hvitis/PingPongLauncher/docs/assets/plates/plate-01.png

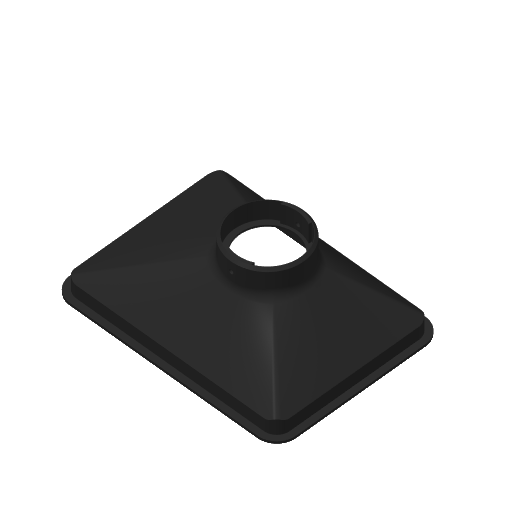
docs/assets/plates/plate-01.png
