hvitis/PingPongLauncher/docs/assets/plates/plate-02.png

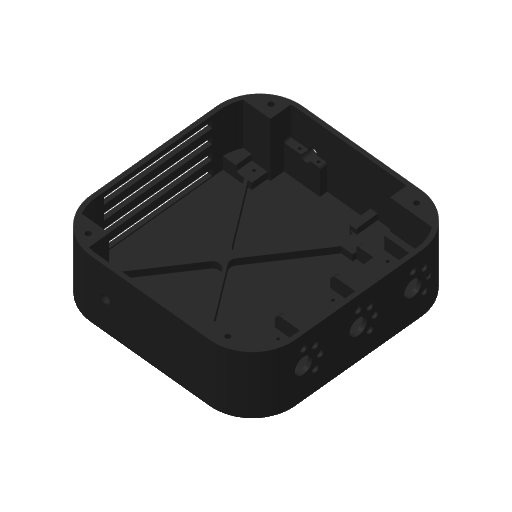
docs/assets/plates/plate-02.png
