hvitis/PingPongLauncher/docs/assets/plates/plate-03.png

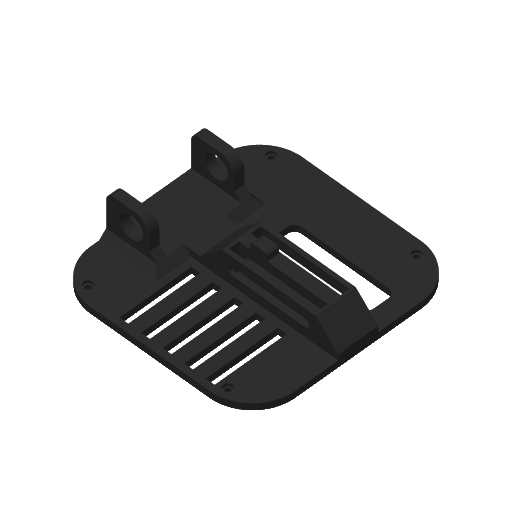
docs/assets/plates/plate-03.png
