hvitis/PingPongLauncher/docs/assets/plates/plate-04.png

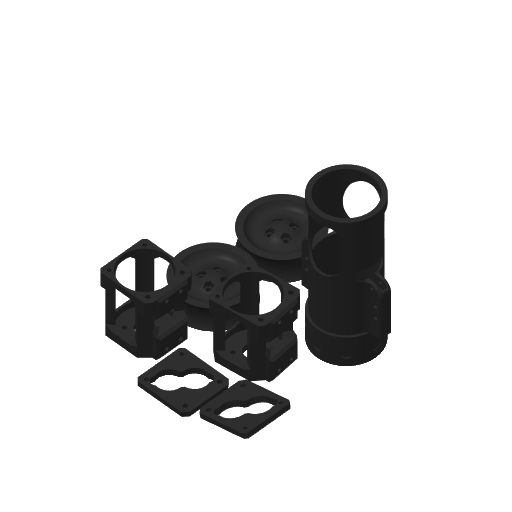
docs/assets/plates/plate-04.png
