hvitis/PingPongLauncher/docs/assets/plates/plate-05.png

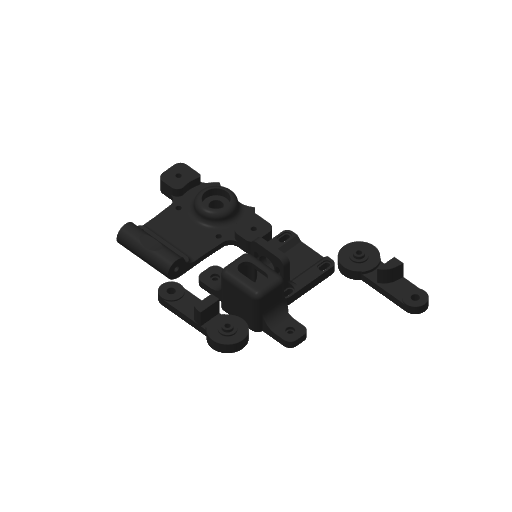
docs/assets/plates/plate-05.png
