hvitis/PingPongLauncher/docs/assets/plates/plate-06.png

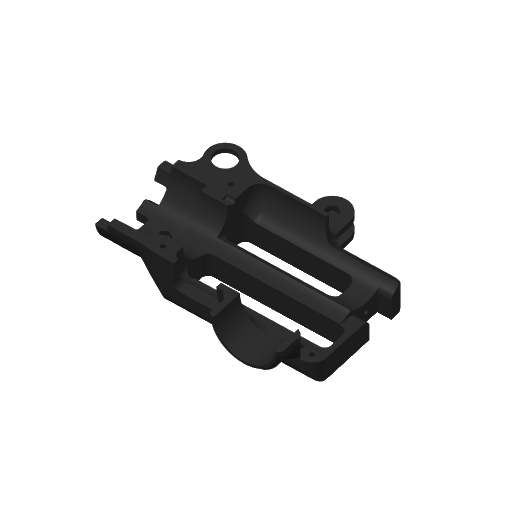
docs/assets/plates/plate-06.png
