hvitis/PingPongLauncher/docs/assets/plates/plate-08.png

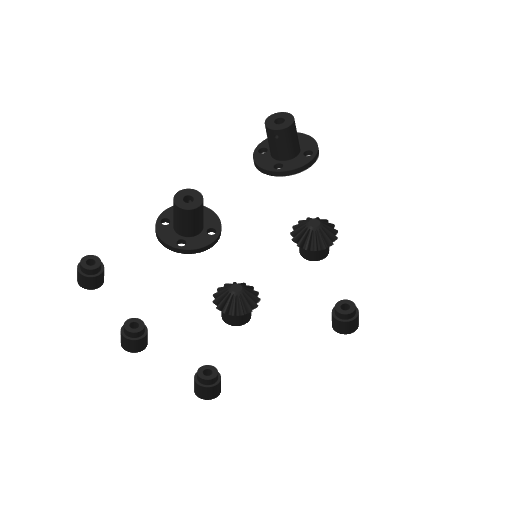
docs/assets/plates/plate-08.png
