hvitis/PingPongLauncher/docs/assets/plates/plate-09.png

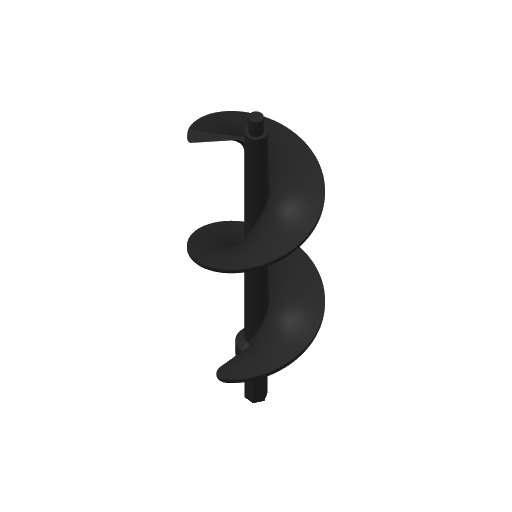
docs/assets/plates/plate-09.png
