hvitis/PingPongLauncher/docs/assets/plates/plate-10.png

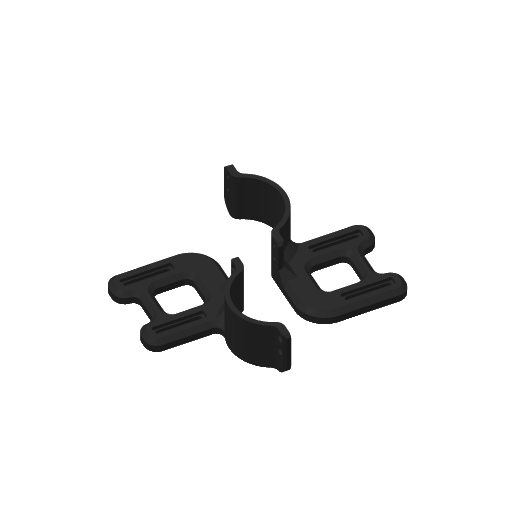
docs/assets/plates/plate-10.png
