hvitis/PingPongLauncher/docs/component-image-sources.md

# Component image sources and reference records

This document records the source photographs, vector illustrations, visual evidence, rights statements, and limitation notes for each component in the bill of materials.

## Purpose and scope

Photographs and SVG illustrations in this build guide serve visual identification only:

- **Listing photo (`listing`)**: Photographed from candidate supplier listings (Botland) to help identify commercial items. Printed pocket fits, batch tolerances, and electrical ratings must still be verified against the physical parts.
- **Reference (`reference`)**: Representative product or hardware family photographs from manufacturer or distributor listings. Used to illustrate general physical appearance; dimensions, grades, lengths, or electrical characteristics may differ from the source specification.
- **Material (`material`)**: Depicts raw material stock (such as a 3D-printing filament spool) rather than a finished or custom-fabricated component (such as a safety guard).

WARNING: These illustrations and photographs depict physical appearance only. They are not dimensioned engineering drawings, CAD models, or certified proof of fit or compatibility. Copyright in product photographs remains with the respective source photographers and retailers.

## Component visual references

| ID | Part | Scope | Photo credit / source | Visible features | Limitations and notes |
|---|---|---|---|---|---|
| H01 | M3 heat-set inserts | Reference | [Prusa / CNC Kitchen product photography](https://www.prusa3d.com/product/heat-set-inserts-m3-standard-100-pcs/) | Brass cylindrical body; Knurled outer bands; Dark threaded center opening | The photo shows a CNC Kitchen M3 insert variant, not a verified M3 × 5 × 5 mm match. |
| H02 | Socket head screws | Reference | [Westfield Fasteners product photography](https://www.westfieldfasteners.co.uk/Bolts-Screws-Metric/Socket-Head-Cap-Screw-M3x65-A4-Stainless.html) | Cylindrical socket head; Recessed hex drive; Silver threaded shank | Socket-screw appearance only. The reference is an A4 fastener family image, not proof of source 304 grade or length. |
| H03 | Socket head screws | Reference | [Westfield Fasteners product photography](https://www.westfieldfasteners.co.uk/Bolts-Screws-Metric/Socket-Head-Cap-Screw-M3x65-A4-Stainless.html) | Cylindrical socket head; Short threaded shank; Metallic finish | The same family photo is used for different screw rows. The diagram is not a scale or length guide. |
| H04 | Socket head screws | Reference | [Westfield Fasteners product photography](https://www.westfieldfasteners.co.uk/Bolts-Screws-Metric/Socket-Head-Cap-Screw-M3x65-A4-Stainless.html) | Cylindrical socket head; Recessed drive; Threaded shank | Family photo only; M3 × 25 mm length and material are specified by the BOM, not established by this illustration. |
| H05 | Socket head screws | Reference | [Westfield Fasteners product photography](https://www.westfieldfasteners.co.uk/Bolts-Screws-Metric/Socket-Head-Cap-Screw-M3x65-A4-Stainless.html) | Long smooth shank on one photographed screw; Threaded end; Cylindrical socket head | The drawing distinguishes a long screw visually but does not define M3 × 65 mm geometry, pitch, or thread length. |
| H06 | Geared feed motor | Reference | [Pololu product photography](https://www.pololu.com/product/4756) | Round metal gearbox face; Output shaft; Motor can and encoder wiring | The photo is a Pololu 4756 with a different body, shaft, and encoder package. It is not a verified feeder replacement. |
| H07 | 550 launch motors | Reference | [Roboteh product photography](https://roboteh.ro/104-motor-dc-cu-perii-550-12v-1000103.html) | Brushed motor can; Vent openings near the front; Small projecting shaft | The Roboteh 550 variant is an appearance reference only. Its dimensions and current are not assigned to this build. |
| H08 | Star knob screws | Reference | [Teamsports / Trainingsunterlagen24 product photography](https://www.teamsports.com/football/training-equipment/rebounders/thumb-screw-knob-m5-x-20-mm/a-3857) | Black scalloped grip; Raised central cap; Short threaded metal stud | The photographed thumb screw has an M5 × 20 mm stud; the source calls for M5 × 12 mm. |
| H09 | M5 hex nuts | Reference | [Botland product photography](https://botland.com.pl/srubki-i-nakretki/806-nakretki-m3-10szt-5904422300982.html) | Six flat sides; Central threaded hole; Beveled metal edges | The reference photo is of M3 nuts. It shows hex-nut appearance only and does not establish the M5 pocket dimensions. |
| H10 | M3 hex nuts | Listing photo | [Botland product photography](https://botland.com.pl/srubki-i-nakretki/806-nakretki-m3-10szt-5904422300982.html) | Hexagonal metal body; Threaded central hole; Beveled outer edges | Photo from the linked Botland M3 nut listing. Check the actual printed pocket fit. |
| H11 | Self-tapping screws | Reference | [CRV Industrial product photography](https://www.crvindustrial.com/produtos/parafuso-auto-atarraxante-panela-fenda-phillips-din-7981) | Rounded pan head; Cross recess; Coarse threads and pointed tip | A generic DIN 7981 family photo; it does not verify the source M3 × 14 mm notation, pilot hole, or dimensions. |
| H12 | Hookup wire | Listing photo | [Botland product photography](https://botland.com.pl/przewody-lgy/6689-przewod-instalacyjny-lgy-1x05-h05v-k-czarny-rolka-100m-5907702813332.html) | Coiled black insulated wire; Stranded copper at the stripped end | Photo from the linked 0.5 mm² wire listing. Its 100 m pack differs from the 5 m source quantity. |
| H13 | DC power supply | Listing photo | [Botland product photography](https://botland.com.pl/zasilanie-pine64/13231-zasilacz-12v-5a-dc-55x21mm-do-pine64-rockpro64-850796007291.html) | Enclosed black adapter; Attached flexible output lead; Barrel connector | The linked adapter is a 12 V / 5 A candidate, not the source 3 A unit. Confirm polarity and the load budget. |
| H14 | Inline switch | Listing photo | [Botland product photography](https://botland.com.pl/przelaczniki-dzwigienkowe/8389-przelacznik-dzwigniowy-on-off-asw-14d-12v20a-podswietlany-zielony-5904422311650.html) | Green translucent lever; Threaded mounting collar; Three contact tabs | The linked panel toggle differs from the source inline switch. The drawing does not specify terminal functions. |
| H15 | PWM motor controllers | Listing photo | [Botland product photography](https://botland.com.pl/sterowniki-silnikow-moduly/13450-cytron-md10-pot-sterownik-silnikow-dc-30v10a-przelacznik-potencjometr-5904422377274.html) | Black rectangular circuit board; Terminal block and capacitor; Pale accessory headers and mounting holes | Photo from the Cytron MD10-POT candidate listing. The original base mounts need redesign for this board. |
| H16 | Bearings | Reference | [Bearings Canada / VXB product photography](https://bearingscanada.com/products/7x16x5mm-non-standard-miniature-bearing) | Concentric steel rings; Exposed balls in a race; Central shaft opening | The source page lists 7 × 16 × 5 mm. This outside-Botland photo is a visual reference, not a fit or supplier approval. |
| H17 | Table tennis rubber + adhesive | Reference | [Butterfly India product photography](https://butterfly-india.com/product/sriver/) | Flat square rubber package; Black upper surface; Red sheet edge | The photograph shows a Butterfly Sriver rubber product. It does not validate tire thickness, cutting dimensions, or adhesive compatibility. Adhesive is not pictured. |
| H18 | Ball stopper + cable ties | Reference | [Botland product photography](https://botland.com.pl/produkty-wycofane/28130-opaski-zaciskowe-25x200mm-nylon-66-biale-100szt-qoltec-52195-5901878521954.html) | Long narrow nylon straps; Rectangular locking heads; Repeated ribbed strap texture | The reference shows cable ties only, from a retired listing. The separate ball stopper can use filament from H21; its fit remains unverified. |
| H19 | Additional CAD fasteners | Reference | [Botland product photography](https://botland.com.pl/srubki-i-nakretki/23456-zestaw-srub-i-nakretek-m3m4m5m6-1000szt-5904257801784.html) | Open transparent organizer; Divided compartments; Mixed screws, nuts, and washers | Assorted hardware is shown for identification. This kit does not supply all extra CAD fasteners and does not picture every required item. |
| H20 | DC connectors, insulation, and branch protection | Listing photo | [Botland product photography](https://botland.com.pl/wtyki-dc/13693-gniazdo-dc-5521mm-do-obudowy-10szt-5904422342029.html) | Metal panel nut and rim; Black socket barrel; Exposed rear solder tabs | Only the linked DC socket is pictured. Branch protection, insulation, and strain relief are separate selections. |
| H21 | Printing filament | Listing photo | [Botland product photography](https://botland.com.pl/filamenty-petg/23711-filament-devil-design-petg-175mm-1kg-graphite-5902280033240.html) | Dark wound filament; Circular spool flanges; Central hub opening and radial supports | Photo from the linked 1.75 mm PETG listing. Spool quantity still comes from the slice total. |
| H22 | 40 mm table tennis balls | Reference | [Gonser product photography](https://www.gonser.ch/tischtennisbaelle-6er-set/a-14887/) | White spherical balls; Matte curved surfaces; Soft contact shadows | Generic ball appearance only; brand, batch behavior, diameter tolerance, and launcher performance are not verified. |
| H23 | Guard material and mounting hardware | Material | [Botland product photography](https://botland.com.pl/filamenty-petg/23711-filament-devil-design-petg-175mm-1kg-graphite-5902280033240.html) | Wound filament; Plastic spool flanges; Circular hub | The image shows candidate printing material, not a designed or validated guard. Guard geometry and mounting are still open. |
| H24 | Stable support and non-slip pads | Reference | [Botland product photography](https://botland.com.pl/produkty-wycofane/1335-nozki-samoprzylepne-okragle-niskie-8mm-4szt-5904422301156.html) | Four round black feet; Short raised profiles; Shared adhesive backing sheet | The retired product photo shows feet only. It does not establish a stable support, base mounting, or required pad size. |

## Source asset records and rights

### Botland product photography (`fastener-kit`)

- **Local photo:** `assets/components/photos/fastener-kit.webp`
- **Source page:** [https://botland.com.pl/srubki-i-nakretki/23456-zestaw-srub-i-nakretek-m3m4m5m6-1000szt-5904257801784.html](https://botland.com.pl/srubki-i-nakretki/23456-zestaw-srub-i-nakretek-m3m4m5m6-1000szt-5904257801784.html)
- **Direct image URL:** [https://cdn2.botland.com.pl/129873-large_default/zestaw-srub-i-nakretek-m3m4m5m6-1000szt.jpg](https://cdn2.botland.com.pl/129873-large_default/zestaw-srub-i-nakretek-m3m4m5m6-1000szt.jpg)
- **Checked on:** 2026-10-26
- **Rights:** Copyright remains with the source. No redistribution license was stated on the inspected product page.
- **Processing:** Full image retained; orientation corrected, maximum 600 pixels, WebP quality 84. No object, logo, or watermark removed.
- **Local photo SHA-256:** `5fbab9a8cceef8f630270e78639e61768cc8090d158ff373281dc6d944097cdc`
- **Original image SHA-256:** `94aa5e6a4b1348182e849995359cb6aa155fbca32572c38f6b0b618a8bdb6594`

### Botland product photography (`hex-nuts`)

- **Local photo:** `assets/components/photos/hex-nuts.webp`
- **Source page:** [https://botland.com.pl/srubki-i-nakretki/806-nakretki-m3-10szt-5904422300982.html](https://botland.com.pl/srubki-i-nakretki/806-nakretki-m3-10szt-5904422300982.html)
- **Direct image URL:** [https://cdn2.botland.com.pl/104775-large_default/nakretki-m3-10szt.jpg](https://cdn2.botland.com.pl/104775-large_default/nakretki-m3-10szt.jpg)
- **Checked on:** 2026-10-26
- **Rights:** Copyright remains with the source. No redistribution license was stated on the inspected product page.
- **Processing:** Full image retained; orientation corrected, maximum 600 pixels, WebP quality 84. No object, logo, or watermark removed.
- **Local photo SHA-256:** `57bee86db1a762c9fcfb69cba154a63b2e0af6228f81602c190897545e0495a0`
- **Original image SHA-256:** `c24e40bfcdc74ebb4d3fe430cc0d56409880aa21cd7eefc4ada0e4082a623a03`

### Botland product photography (`hookup-wire`)

- **Local photo:** `assets/components/photos/hookup-wire.webp`
- **Source page:** [https://botland.com.pl/przewody-lgy/6689-przewod-instalacyjny-lgy-1x05-h05v-k-czarny-rolka-100m-5907702813332.html](https://botland.com.pl/przewody-lgy/6689-przewod-instalacyjny-lgy-1x05-h05v-k-czarny-rolka-100m-5907702813332.html)
- **Direct image URL:** [https://cdn3.botland.com.pl/25316-large_default/przewod-instalacyjny-lgy-1x05-h05v-k-czarny-rolka-100m.jpg](https://cdn3.botland.com.pl/25316-large_default/przewod-instalacyjny-lgy-1x05-h05v-k-czarny-rolka-100m.jpg)
- **Checked on:** 2026-10-26
- **Rights:** Copyright remains with the source. No redistribution license was stated on the inspected product page.
- **Processing:** Full image retained; orientation corrected, maximum 600 pixels, WebP quality 84. No object, logo, or watermark removed.
- **Local photo SHA-256:** `0ce87a5ea02b954e0f8ffe85fd0629052a55f2a90b92bae420ea00b682df9d94`
- **Original image SHA-256:** `47eee72fbdbb6bd568259e7022ba5fa575754cb0195552467156a531aa3177cc`

### Botland product photography (`dc-adapter`)

- **Local photo:** `assets/components/photos/dc-adapter.webp`
- **Source page:** [https://botland.com.pl/zasilanie-pine64/13231-zasilacz-12v-5a-dc-55x21mm-do-pine64-rockpro64-850796007291.html](https://botland.com.pl/zasilanie-pine64/13231-zasilacz-12v-5a-dc-55x21mm-do-pine64-rockpro64-850796007291.html)
- **Direct image URL:** [https://cdn3.botland.com.pl/51961-large_default/zasilacz-12v-5a-dc-55x21mm-do-pine64-rockpro64.jpg](https://cdn3.botland.com.pl/51961-large_default/zasilacz-12v-5a-dc-55x21mm-do-pine64-rockpro64.jpg)
- **Checked on:** 2026-10-26
- **Rights:** Copyright remains with the source. No redistribution license was stated on the inspected product page.
- **Processing:** Full image retained; orientation corrected, maximum 600 pixels, WebP quality 84. No object, logo, or watermark removed.
- **Local photo SHA-256:** `947c37e753f6ad9ed1454d066f8c8852c41198e6f9431d8bd0f63b30754b2fc6`
- **Original image SHA-256:** `59ad028c42dfe575c6c42abf75bb4766a8d7590f2260b878d89e8d0548a9565f`

### Botland product photography (`toggle-switch`)

- **Local photo:** `assets/components/photos/toggle-switch.webp`
- **Source page:** [https://botland.com.pl/przelaczniki-dzwigienkowe/8389-przelacznik-dzwigniowy-on-off-asw-14d-12v20a-podswietlany-zielony-5904422311650.html](https://botland.com.pl/przelaczniki-dzwigienkowe/8389-przelacznik-dzwigniowy-on-off-asw-14d-12v20a-podswietlany-zielony-5904422311650.html)
- **Direct image URL:** [https://cdn2.botland.com.pl/92509-large_default/przelacznik-dzwigniowy-on-off-asw-14d-12v20a-podswietlany-zielony.jpg](https://cdn2.botland.com.pl/92509-large_default/przelacznik-dzwigniowy-on-off-asw-14d-12v20a-podswietlany-zielony.jpg)
- **Checked on:** 2026-10-26
- **Rights:** Copyright remains with the source. No redistribution license was stated on the inspected product page.
- **Processing:** Full image retained; orientation corrected, maximum 600 pixels, WebP quality 84. No object, logo, or watermark removed.
- **Local photo SHA-256:** `daa49b3883bdf66805aca4f0b6c7d821798997aa03b8d13dd85959f88e8950ca`
- **Original image SHA-256:** `7e721c1b34938e53d98279d64b00568277fb5e909efbfecb1dec452f692e2547`

### Botland product photography (`pwm-controller`)

- **Local photo:** `assets/components/photos/pwm-controller.webp`
- **Source page:** [https://botland.com.pl/sterowniki-silnikow-moduly/13450-cytron-md10-pot-sterownik-silnikow-dc-30v10a-przelacznik-potencjometr-5904422377274.html](https://botland.com.pl/sterowniki-silnikow-moduly/13450-cytron-md10-pot-sterownik-silnikow-dc-30v10a-przelacznik-potencjometr-5904422377274.html)
- **Direct image URL:** [https://cdn2.botland.com.pl/52914-large_default/cytron-md10-pot-sterownik-silnikow-dc-30v10a-przelacznik-potencjometr.jpg](https://cdn2.botland.com.pl/52914-large_default/cytron-md10-pot-sterownik-silnikow-dc-30v10a-przelacznik-potencjometr.jpg)
- **Checked on:** 2026-10-26
- **Rights:** Copyright remains with the source. No redistribution license was stated on the inspected product page.
- **Processing:** Full image retained; orientation corrected, maximum 600 pixels, WebP quality 84. No object, logo, or watermark removed.
- **Local photo SHA-256:** `58e0acbc5de752e326922486d1027dc56e45daf92d2d6abb302317131a1da4cc`
- **Original image SHA-256:** `6657d53b8211908c15f8346c199e026d2f7549dad0c91219ce8fd0bde33e8099`

### Botland product photography (`dc-socket`)

- **Local photo:** `assets/components/photos/dc-socket.webp`
- **Source page:** [https://botland.com.pl/wtyki-dc/13693-gniazdo-dc-5521mm-do-obudowy-10szt-5904422342029.html](https://botland.com.pl/wtyki-dc/13693-gniazdo-dc-5521mm-do-obudowy-10szt-5904422342029.html)
- **Direct image URL:** [https://cdn3.botland.com.pl/53896-large_default/gniazdo-dc-5521mm-do-obudowy-10szt.jpg](https://cdn3.botland.com.pl/53896-large_default/gniazdo-dc-5521mm-do-obudowy-10szt.jpg)
- **Checked on:** 2026-10-26
- **Rights:** Copyright remains with the source. No redistribution license was stated on the inspected product page.
- **Processing:** Full image retained; orientation corrected, maximum 600 pixels, WebP quality 84. No object, logo, or watermark removed.
- **Local photo SHA-256:** `eade0f13095740643f577174358a2fc6b93ea492753fc132417258c9e7cef94e`
- **Original image SHA-256:** `c67fce01106180550ea77c92cb9e036716fd2468e72ad1d6e1e7bdca28e79527`

### Botland product photography (`petg-spool`)

- **Local photo:** `assets/components/photos/petg-spool.webp`
- **Source page:** [https://botland.com.pl/filamenty-petg/23711-filament-devil-design-petg-175mm-1kg-graphite-5902280033240.html](https://botland.com.pl/filamenty-petg/23711-filament-devil-design-petg-175mm-1kg-graphite-5902280033240.html)
- **Direct image URL:** [https://cdn1.botland.com.pl/124948-large_default/filament-devil-design-petg-175mm-1kg-graphite.jpg](https://cdn1.botland.com.pl/124948-large_default/filament-devil-design-petg-175mm-1kg-graphite.jpg)
- **Checked on:** 2026-10-26
- **Rights:** Copyright remains with the source. No redistribution license was stated on the inspected product page.
- **Processing:** Full image retained; orientation corrected, maximum 600 pixels, WebP quality 84. No object, logo, or watermark removed.
- **Local photo SHA-256:** `d257a312c524b60419ad9bd65603a8b07f7e2c61aa68794a648ea8e2e7e059d8`
- **Original image SHA-256:** `eaeb266093fc889a16aaa305aa54fde81260624c170a8ab77e5b8f5f61101a1c`

### Prusa / CNC Kitchen product photography (`heat-insert`)

- **Local photo:** `assets/components/photos/heat-insert.webp`
- **Source page:** [https://www.prusa3d.com/product/heat-set-inserts-m3-standard-100-pcs/](https://www.prusa3d.com/product/heat-set-inserts-m3-standard-100-pcs/)
- **Direct image URL:** [https://www.prusa3d.com/content/images/product/3461.png](https://www.prusa3d.com/content/images/product/3461.png)
- **Checked on:** 2026-10-26
- **Rights:** Copyright remains with the source. No redistribution license was stated on the inspected product page.
- **Processing:** Full image retained; orientation corrected, maximum 600 pixels, WebP quality 84. No object, logo, or watermark removed.
- **Local photo SHA-256:** `664a901d66ef0b0c5418a30bd9217e86919de1ffc92c740245dd3a67e05f61ac`
- **Original image SHA-256:** `66c221f61b7daa70fde6ba00fd12df38ae34d0cbf0447a43acbc9902e92dbe24`

### Westfield Fasteners product photography (`socket-screws`)

- **Local photo:** `assets/components/photos/socket-screws.webp`
- **Source page:** [https://www.westfieldfasteners.co.uk/Bolts-Screws-Metric/Socket-Head-Cap-Screw-M3x65-A4-Stainless.html](https://www.westfieldfasteners.co.uk/Bolts-Screws-Metric/Socket-Head-Cap-Screw-M3x65-A4-Stainless.html)
- **Direct image URL:** [https://www.westfieldfasteners.co.uk/Images3/Main_Images_Published/Socket-Head-Cap-Screws-DIN-912-ISO-4762-in-A4.jpg](https://www.westfieldfasteners.co.uk/Images3/Main_Images_Published/Socket-Head-Cap-Screws-DIN-912-ISO-4762-in-A4.jpg)
- **Checked on:** 2026-10-26
- **Rights:** Copyright remains with the source. No redistribution license was stated on the inspected product page.
- **Processing:** Full image retained; orientation corrected, maximum 600 pixels, WebP quality 84. No object, logo, or watermark removed.
- **Local photo SHA-256:** `378ee2a6fd2890e0e695316e6b3fd225fa5706e5bb96ae8d29496ebaf891f9b2`
- **Original image SHA-256:** `4579c38d866d551d52c4f51cbdcd0183392125ac3c6429631c13bbafa8b22695`

### Roboteh product photography (`launch-motor`)

- **Local photo:** `assets/components/photos/launch-motor.webp`
- **Source page:** [https://roboteh.ro/104-motor-dc-cu-perii-550-12v-1000103.html](https://roboteh.ro/104-motor-dc-cu-perii-550-12v-1000103.html)
- **Direct image URL:** [https://roboteh.ro/973-large_default/motor-dc-cu-perii-550-12v.webp](https://roboteh.ro/973-large_default/motor-dc-cu-perii-550-12v.webp)
- **Checked on:** 2026-10-26
- **Rights:** Copyright remains with the source. No redistribution license was stated on the inspected product page.
- **Processing:** Full image retained; orientation corrected, maximum 600 pixels, WebP quality 84. No object, logo, or watermark removed.
- **Local photo SHA-256:** `c2ec12eb2bb622cb5ecfd9431cd05db6f17c06ee481e14e809f974aed1a23ef3`
- **Original image SHA-256:** `5762a743d92138ff18ec047e361508bb3e43e7571ee2f4e2ce3181af5850eeef`

### Pololu product photography (`geared-motor`)

- **Local photo:** `assets/components/photos/geared-motor.webp`
- **Source page:** [https://www.pololu.com/product/4756](https://www.pololu.com/product/4756)
- **Direct image URL:** [https://a.pololu-files.com/picture/0J10475.600x480.jpg?c6fa223e61c70833661495e0747913c8](https://a.pololu-files.com/picture/0J10475.600x480.jpg?c6fa223e61c70833661495e0747913c8)
- **Checked on:** 2026-10-26
- **Rights:** Copyright remains with the source. No redistribution license was stated on the inspected product page.
- **Processing:** Full image retained; orientation corrected, maximum 600 pixels, WebP quality 84. No object, logo, or watermark removed.
- **Local photo SHA-256:** `6a6ce65679c1dab9aa838251b2c9ac7759b3dbc42cb010f01ea1d93109137ff4`
- **Original image SHA-256:** `1ec444acf4a9472b10efdd4ed1c9108a03eb58511dc326e5511a915dd3ab873b`

### Bearings Canada / VXB product photography (`ball-bearing`)

- **Local photo:** `assets/components/photos/ball-bearing.webp`
- **Source page:** [https://bearingscanada.com/products/7x16x5mm-non-standard-miniature-bearing](https://bearingscanada.com/products/7x16x5mm-non-standard-miniature-bearing)
- **Direct image URL:** [https://bearingscanada.com/cdn/shop/files/7x16x5mm-non-standard-miniature-bearing-7mm-x-16mm-x-5mm-vxb-ball-bearings.jpg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](https://bearingscanada.com/cdn/shop/files/7x16x5mm-non-standard-miniature-bearing-7mm-x-16mm-x-5mm-vxb-ball-bearings.jpg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)
- **Checked on:** 2026-10-26
- **Rights:** Copyright remains with the source. No redistribution license was stated on the inspected product page.
- **Processing:** Full image retained; orientation corrected, maximum 600 pixels, WebP quality 84. No object, logo, or watermark removed.
- **Local photo SHA-256:** `2329ff9df70ddef07a69b2a2a12aacfd6409e7e44ce4a85005d5356d04b9b662`
- **Original image SHA-256:** `42e9021980320d23d57272bf708fe343aa99b009679c902b975e2653885937d3`

### Butterfly India product photography (`table-tennis-rubber`)

- **Local photo:** `assets/components/photos/table-tennis-rubber.webp`
- **Source page:** [https://butterfly-india.com/product/sriver/](https://butterfly-india.com/product/sriver/)
- **Direct image URL:** [https://butterfly-india.com/wp-content/uploads/2024/10/SRIVER-700x700.webp](https://butterfly-india.com/wp-content/uploads/2024/10/SRIVER-700x700.webp)
- **Checked on:** 2026-10-26
- **Rights:** Copyright remains with the source. No redistribution license was stated on the inspected product page.
- **Processing:** Full image retained; orientation corrected, maximum 600 pixels, WebP quality 84. No object, logo, or watermark removed.
- **Local photo SHA-256:** `66d67d0a6b7f291423ac7299b99b25f68f312ccce822aada0ce54e1963216862`
- **Original image SHA-256:** `7d25903142db701acc367f23af48a7257445a467e7728e93e07308b6e24de142`

### Gonser product photography (`table-tennis-balls`)

- **Local photo:** `assets/components/photos/table-tennis-balls.webp`
- **Source page:** [https://www.gonser.ch/tischtennisbaelle-6er-set/a-14887/](https://www.gonser.ch/tischtennisbaelle-6er-set/a-14887/)
- **Direct image URL:** [https://cdn10.plentymarkets.com/mrt54q44tptl/item/images/14887/full/Tischtennis-Baelle-Pingpong-Ball-Set-NEU.jpg](https://cdn10.plentymarkets.com/mrt54q44tptl/item/images/14887/full/Tischtennis-Baelle-Pingpong-Ball-Set-NEU.jpg)
- **Checked on:** 2026-10-26
- **Rights:** Copyright remains with the source. No redistribution license was stated on the inspected product page.
- **Processing:** Full image retained; orientation corrected, maximum 600 pixels, WebP quality 84. No object, logo, or watermark removed.
- **Local photo SHA-256:** `fc009dea90bf076b6cd895d5a3c7bb25738446f9039ecfd03aa9b8b249fcbe63`
- **Original image SHA-256:** `cb020a7d012402ea1337b2bd363c53f4e15c0722812dfe1e78ca8f4176e8460a`

### Botland product photography (`non-slip-feet`)

- **Local photo:** `assets/components/photos/non-slip-feet.webp`
- **Source page:** [https://botland.com.pl/produkty-wycofane/1335-nozki-samoprzylepne-okragle-niskie-8mm-4szt-5904422301156.html](https://botland.com.pl/produkty-wycofane/1335-nozki-samoprzylepne-okragle-niskie-8mm-4szt-5904422301156.html)
- **Direct image URL:** [https://cdn2.botland.com.pl/62776-large_default/nozki-samoprzylepne-okragle-niskie-8mm-4szt.jpg](https://cdn2.botland.com.pl/62776-large_default/nozki-samoprzylepne-okragle-niskie-8mm-4szt.jpg)
- **Checked on:** 2026-10-26
- **Rights:** Copyright remains with the source. No redistribution license was stated on the inspected product page.
- **Processing:** Full image retained; orientation corrected, maximum 600 pixels, WebP quality 84. No object, logo, or watermark removed.
- **Local photo SHA-256:** `eaa66502f062f1724e9ed6ce3caa3a87a2aad643282716daffc7e57d23af205a`
- **Original image SHA-256:** `212f9743f483e9169063e96f0bbc59a34a41f295ef62115ce1ca38fe7e0c9024`

### Teamsports / Trainingsunterlagen24 product photography (`star-knob`)

- **Local photo:** `assets/components/photos/star-knob.webp`
- **Source page:** [https://www.teamsports.com/football/training-equipment/rebounders/thumb-screw-knob-m5-x-20-mm/a-3857](https://www.teamsports.com/football/training-equipment/rebounders/thumb-screw-knob-m5-x-20-mm/a-3857)
- **Direct image URL:** [https://cdn02.plentymarkets.com/zkz64ybyye6y/item/images/3857/full/xxxx--Sterngriffschraube--003.jpg](https://cdn02.plentymarkets.com/zkz64ybyye6y/item/images/3857/full/xxxx--Sterngriffschraube--003.jpg)
- **Checked on:** 2026-10-26
- **Rights:** Copyright remains with the source. No redistribution license was stated on the inspected product page.
- **Processing:** Full image retained; orientation corrected, maximum 600 pixels, WebP quality 84. No object, logo, or watermark removed.
- **Local photo SHA-256:** `cddf5f42b3ad950cf2ee6c811b72f4cff641319ba80f3cff247c7203553d77b2`
- **Original image SHA-256:** `55c4b28ecbcd31168e75195c4361a504199ead4c0436d5f448f4dd6d2cd9b62a`

### CRV Industrial product photography (`self-tapping-screw`)

- **Local photo:** `assets/components/photos/self-tapping-screw.webp`
- **Source page:** [https://www.crvindustrial.com/produtos/parafuso-auto-atarraxante-panela-fenda-phillips-din-7981](https://www.crvindustrial.com/produtos/parafuso-auto-atarraxante-panela-fenda-phillips-din-7981)
- **Direct image URL:** [https://www.crvindustrial.com/admin/files/produto/original__a8d16e9a_parafuso_auto_atarraxante_panela_fenda_phillips_01.jpg](https://www.crvindustrial.com/admin/files/produto/original__a8d16e9a_parafuso_auto_atarraxante_panela_fenda_phillips_01.jpg)
- **Checked on:** 2026-10-26
- **Rights:** Copyright remains with the source. No redistribution license was stated on the inspected product page.
- **Processing:** Full image retained; orientation corrected, maximum 600 pixels, WebP quality 84. No object, logo, or watermark removed.
- **Local photo SHA-256:** `9dd725a8455ee35d8d5c5046514c73d50a9fd7fb30d5941b68f4c978e5168aa1`
- **Original image SHA-256:** `48db13f448a057f5d7323ef8d9bf043ecdead1ef569a6600240a1e4aaef57fbf`

### Botland product photography (`cable-ties`)

- **Local photo:** `assets/components/photos/cable-ties.webp`
- **Source page:** [https://botland.com.pl/produkty-wycofane/28130-opaski-zaciskowe-25x200mm-nylon-66-biale-100szt-qoltec-52195-5901878521954.html](https://botland.com.pl/produkty-wycofane/28130-opaski-zaciskowe-25x200mm-nylon-66-biale-100szt-qoltec-52195-5901878521954.html)
- **Direct image URL:** [https://cdn3.botland.com.pl/141873-large_default/opaski-zaciskowe-25x200mm-nylon-66-biale-100szt-qoltec-52195.jpg](https://cdn3.botland.com.pl/141873-large_default/opaski-zaciskowe-25x200mm-nylon-66-biale-100szt-qoltec-52195.jpg)
- **Checked on:** 2026-10-26
- **Rights:** Copyright remains with the source. No redistribution license was stated on the inspected product page.
- **Processing:** Full image retained; orientation corrected, maximum 600 pixels, WebP quality 84. No object, logo, or watermark removed.
- **Local photo SHA-256:** `22e7489befcc002ffe162dfee58dbf19e22e27b892a66c599ee956c2fd47f290`
- **Original image SHA-256:** `81ad02a60de78c39b07acd37f42f000583b9bb1411842d4669627498653b1003`
