hvitis/PingPongLauncher/docs/downloads/hardware-bom.csv

ID | Part | Specification | Quantity | Category | Source | Build note | Botland status | Botland links | Link types | Compatibility note | Purchase/pack note | Checked on
H01 | M3 heat-set inserts | M3 × 5 × 5 mm, source notation | 20 | Fasteners | Spreadsheet, row 2 | Confirm outside diameter and length against the printed pockets. | No verified match | https://botland.com.pl/11-elementy-montazowe | category | No current M3 × 5 × 5 mm insert was verified. The retired Botland insert set lists a different M3 outside diameter. Confirm the actual printed pocket. |  | 2026-10-26
H02 | Socket head screws | M3 × 20 mm, 304 stainless steel | 10+ | Fasteners | Spreadsheet, row 3 | CAD also contains M3 × 18 mm screws. Measure each joint before installation. | Alternative · check fit | https://botland.com.pl/srubki-i-nakretki/23456-zestaw-srub-i-nakretek-m3m4m5m6-1000szt-5904257801784.html | product | The shared kit lists 25 M3 × 20 mm screws. Socket-head geometry and 304 stainless steel are not confirmed. Compare the head clearance before substitution. | One shared kit can cover H02, H03, and H09. Do not buy one kit for every row. | 2026-10-26
H03 | Socket head screws | M3 × 10 mm, 304 stainless steel | 50 | Fasteners | Spreadsheet, row 4 | Do not assume that every screw position uses this length. | Alternative · check fit | https://botland.com.pl/srubki-i-nakretki/23456-zestaw-srub-i-nakretek-m3m4m5m6-1000szt-5904257801784.html | product | The shared kit lists 50 M3 × 10 mm screws. Socket-head geometry and 304 stainless steel are not confirmed. | Included in the same kit linked in H02. | 2026-10-26
H04 | Socket head screws | M3 × 25 mm, 304 stainless steel | 2 | Fasteners | Spreadsheet, row 5 | Compare with the rear support in the CAD. | No verified match | https://botland.com.pl/120-srubki-i-nakretki | category | No M3 × 25 mm socket-head product was verified. The linked shared kit does not list M3 × 25 mm screws. |  | 2026-10-26
H05 | Socket head screws | M3 × 65 mm, 304 stainless steel | 10 | Fasteners | Spreadsheet, row 6 | Source purchase quantity, not a confirmed installed count. | No verified match | https://botland.com.pl/120-srubki-i-nakretki | category | No M3 × 65 mm socket-head product was verified. Source this length separately after confirming the CAD joint. |  | 2026-10-26
H06 | Geared feed motor | 12 V · 77 rpm · source torque notation: 2 kg | 1 | Electronics | Spreadsheet, row 7 | Torque unit is incomplete. Confirm shaft diameter, mounting, rated current, and stall current. | No verified match | https://botland.com.pl/328-silniki-dc-standard-z-przekladnia | category | No 12 V / 77 rpm motor with a verified matching body, shaft, and mounting pattern was found. A similar rpm alone does not establish fit. |  | 2026-10-26
H07 | 550 launch motors | 12 V · body Ø35.8 mm · source Hmin = 52+ mm | 2 | Electronics | Spreadsheet, row 8 | Confirm body length reference, shaft diameter, shaft length, speed, and current before buying. | No verified match | https://botland.com.pl/5-silniki | category | No matching 12 V 550 motor with the source Ø35.8 mm body and confirmed shaft dimensions was verified. |  | 2026-10-26
H08 | Star knob screws | M5 × 12 mm | 2 | Fasteners | Spreadsheet, row 9 | CAD also shows an M5 × 35 mm tilt bolt, wing nut, and washer, absent from this purchase list. | No verified match | https://botland.com.pl/120-srubki-i-nakretki | category | No M5 × 12 mm star-knob screw was verified. A normal M5 screw is not a confirmed substitute for this adjustment handle. |  | 2026-10-26
H09 | M5 hex nuts | M5 | 2 | Fasteners | Spreadsheet, row 10 | Confirm the printed nut pockets. | Listed spec matches | https://botland.com.pl/srubki-i-nakretki/23456-zestaw-srub-i-nakretek-m3m4m5m6-1000szt-5904257801784.html | product | The shared kit lists 40 M5 nuts. Confirm the nut shape and width against the printed pocket. | Use the same kit as H02/H03; only two M5 nuts are specified by the source. | 2026-10-26
H10 | M3 hex nuts | M3 | About 20 | Fasteners | Spreadsheet, row 11 | The source says a small quantity, approximately 20. | Listed spec matches | https://botland.com.pl/srubki-i-nakretki/806-nakretki-m3-10szt-5904422300982.html | product | Metal M3 nuts, ten per pack. Confirm fit in the printed nut pockets. | Two 10-packs cover about 20 nuts. Skip these packs if using the shared kit, which already lists 100 M3 nuts. | 2026-10-26
H11 | Self-tapping screws | M3 × 14 mm, source notation | About 20 | Fasteners | Spreadsheet, row 12 | The source suggests buying 100 if a small pack is unavailable. Confirm thread and pilot-hole fit. | No verified match | https://botland.com.pl/120-srubki-i-nakretki | category | No M3 × 14 mm self-tapping product was verified. M3 × 14 mm machine screws in a kit do not replace self-tapping screws. |  | 2026-10-26
H12 | Hookup wire | 0.5 mm², source suggestion | 5 m | Electronics | Spreadsheet, row 13 | Confirm wire rating for the actual motor current and installation. | Listed spec matches | https://botland.com.pl/przewody-lgy/6689-przewod-instalacyjny-lgy-1x05-h05v-k-czarny-rolka-100m-5907702813332.html | product | Stranded copper wire with a 0.5 mm² cross-section. Confirm its rating for the measured branch current. | Sold as a 100 m roll; the source calls for 5 m. A smaller length from another supplier can avoid surplus. | 2026-10-26
H13 | DC power supply | 12 V · 3 A · 36 W | 1 | Electronics | Spreadsheet, row 14 | This is the source specification, not a verified system power budget. Use an enclosed, isolated supply. | Alternative · check fit | https://botland.com.pl/zasilanie-pine64/13231-zasilacz-12v-5a-dc-55x21mm-do-pine64-rockpro64-850796007291.html | product | Enclosed 12 V / 5 A adapter with a 5.5 × 2.1 mm plug. This differs from the source 3 A supply. Confirm polarity, connector fit, and the complete measured current budget. | One adapter is a candidate only after the real load and protection are selected. | 2026-10-26
H14 | Inline switch | Source keyword: hand-operated inline switch | 1 | Electronics | Spreadsheet, row 15 | Source says to switch the live conductor. This guide uses a DC-rated switch in the +12 V lead only. | Alternative · check fit | https://botland.com.pl/przelaczniki-dzwigienkowe/8389-przelacznik-dzwigniowy-on-off-asw-14d-12v20a-podswietlany-zielony-5904422311650.html | product | The ASW-14D listing specifies 12 V / 20 A. It is a panel toggle, not the source inline switch. Confirm DC motor-load suitability, wiring, and the required mounting hole. | One switch; requires a suitable panel or separate switch enclosure. | 2026-10-26
H15 | PWM motor controllers | Youxin type in source · one per motor | 3 | Electronics | Spreadsheet, row 16 | Other brands can have different dimensions and mounting holes. Confirm voltage and motor-current ratings. | Alternative · check fit | https://botland.com.pl/sterowniki-silnikow-moduly/13450-cytron-md10-pot-sterownik-silnikow-dc-30v10a-przelacznik-potencjometr-5904422377274.html | product | Cytron MD10-POT: 7–30 V, 10 A continuous, manual potentiometer. Its 81.28 × 48.26 mm board differs from the source mounts; the base layout needs redesign. Confirm motor currents. No reverse-polarity protection. | Three controllers, one per motor, only if the redesigned mounting and electrical ratings are confirmed. | 2026-10-26
H16 | Bearings | 7 mm bore × 16 mm OD × 5 mm width | 4 | Mechanical | Spreadsheet, row 17 | Source notation: d=7, D=16, h=5. Confirm shaft and pocket fit. | No verified match | https://botland.com.pl/11-elementy-montazowe | category | No bearing with the exact 7 mm bore × 16 mm OD × 5 mm width was verified. Do not replace it with a similar bearing size. |  | 2026-10-26
H17 | Table tennis rubber + adhesive | Rubber strips for both launch wheels; source adhesive: 502 cyanoacrylate | To fit | Consumables | Annotated image 3 | Rubber thickness and strip length are not specified. Keep both wheels balanced. | No verified match |  |  | No complete wheel-rubber and compatible adhesive combination was verified. Source table tennis rubber and select adhesive for the actual rubber and PETG. |  | 2026-10-26
H18 | Ball stopper + cable ties | Short filament piece or thin shaft; source mentions 10 mm | To fit | Consumables | Annotated image 3 and prototype photographs | The 10 mm reference is ambiguous. Confirm length and position against the photographs. | Partial supply | https://botland.com.pl/filamenty-petg/23711-filament-devil-design-petg-175mm-1kg-graphite-5902280033240.html | product | A short piece of filament can provide the source stopper material. The filament does not cover the cable ties. Confirm the ambiguous stopper length and source ties separately. | Use an offcut from H21; do not buy a separate spool for this row. | 2026-10-26
H19 | Additional CAD fasteners | M3 × 15 mm; M3 × 18 mm; M5 × 35 mm; M5 wing nut and washer | Confirm in CAD | Fasteners | STEP assembly component names | These appear in the CAD but are missing or different in the spreadsheet. Resolve before ordering. | No verified match | https://botland.com.pl/120-srubki-i-nakretki | category | No complete set covering the extra M3 × 15/18 mm and M5 × 35 mm fasteners, wing nut, and washer was verified. |  | 2026-10-26
H20 | DC connectors, insulation, and branch protection | Matching DC inlet, strain relief, insulated terminals, and selected protection | Design to confirm | Electronics | Guide addition, not in source BOM | Connector polarity, fuse values, and branch current limits need confirmation before power-on. | Partial supply | https://botland.com.pl/wtyki-dc/13693-gniazdo-dc-5521mm-do-obudowy-10szt-5904422342029.html | product | The 5.5 × 2.1 mm panel socket matches the nominal plug size of H13’s candidate adapter. Confirm its current rating and panel fit. Insulation, strain relief, and selected branch protection remain separate. | The socket is sold in a 10-pack; the installation needs one inlet. Other electrical items are not included. | 2026-10-26
H21 | Printing filament | 1.75 mm PETG in the source project; match the selected printer/material profile | Confirm from slice total | Consumables | 3MF filament slot 1 | Use the slicer total for all ten plates, plus supports and trial prints. No spool count or mass is verified. | Listed spec matches | https://botland.com.pl/filamenty-petg/23711-filament-devil-design-petg-175mm-1kg-graphite-5902280033240.html | product | Devil Design PETG, 1.75 mm, 1 kg, Graphite. This matches the saved material type and diameter. Use a profile for the actual filament; printed fit remains unverified. | Confirm spool quantity from all ten sliced plates, supports, and trial prints. The same spool can supply H18 and guard material. | 2026-10-26
H22 | 40 mm table tennis balls | Consistent 40 mm balls for initial trials | At least 3 for trials | Consumables | STEP ball diameter + guide trial quantity | The trial quantity is a guide suggestion, not a verified hopper capacity. | No verified match |  |  | No matching 40 mm table tennis ball listing was verified at Botland. Use a sports supplier. |  | 2026-10-26
H23 | Guard material and mounting hardware | Guards for accessible wheels, feeder, and gears | To match guard design | Mechanical | Guide addition, not in source BOM | No validated guard design is supplied. Confirm material, clearance, and attachment before selecting or printing parts. | Partial supply | https://botland.com.pl/filamenty-petg/23711-filament-devil-design-petg-175mm-1kg-graphite-5902280033240.html | product | PETG is available as a candidate guard-printing material. No guard geometry, thickness, attachment, or clearance is validated by this link. | Share H21 material if the verified guard design uses PETG; mounting hardware remains to be selected. | 2026-10-26
H24 | Stable support and non-slip pads | Rigid support matched to the launcher base and trial area | 1 installation | Mechanical | Guide addition, not in source BOM | Select the mounting method after inspecting the base and the chosen work surface. Mounting fasteners are not specified. | No verified match | https://botland.com.pl/11-elementy-montazowe | category | A rigid support, mounting fasteners, and non-slip pads need selection for the actual work surface. No complete matching installation was verified. |  | 2026-10-26
