hvitis/PingPongLauncher/docs/assets/components/photos/ball-bearing.webp

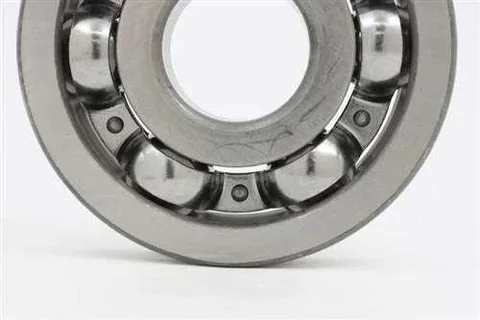
docs/assets/components/photos/ball-bearing.webp
