hvitis/PingPongLauncher/docs/assets/components/photos/cable-ties.webp

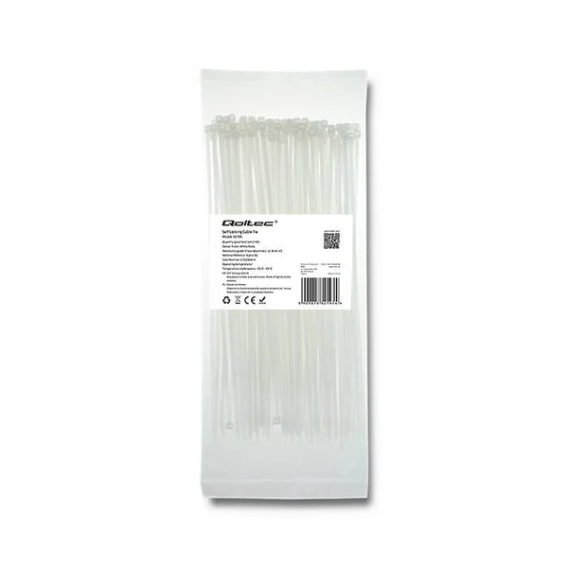
docs/assets/components/photos/cable-ties.webp
