hvitis/PingPongLauncher/docs/assets/components/photos/dc-adapter.webp

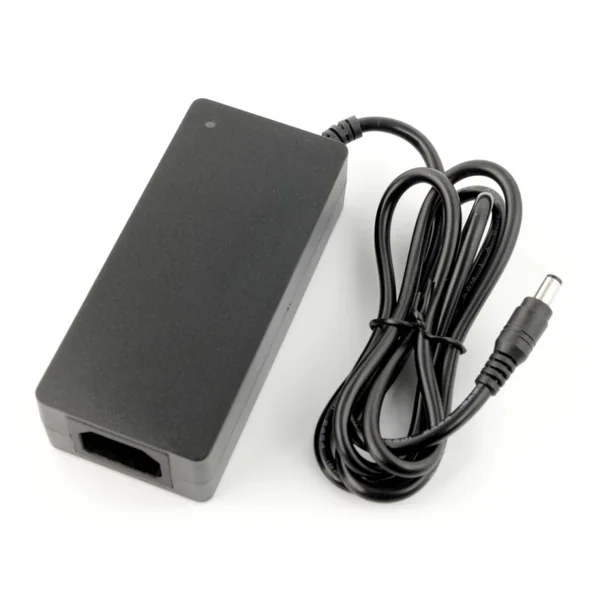
docs/assets/components/photos/dc-adapter.webp
