hvitis/PingPongLauncher/docs/assets/components/photos/dc-socket.webp

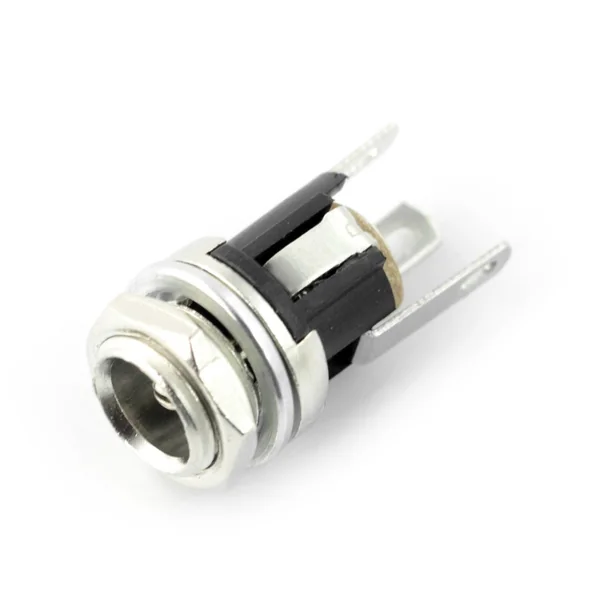
docs/assets/components/photos/dc-socket.webp
