hvitis/PingPongLauncher/docs/assets/components/photos/fastener-kit.webp

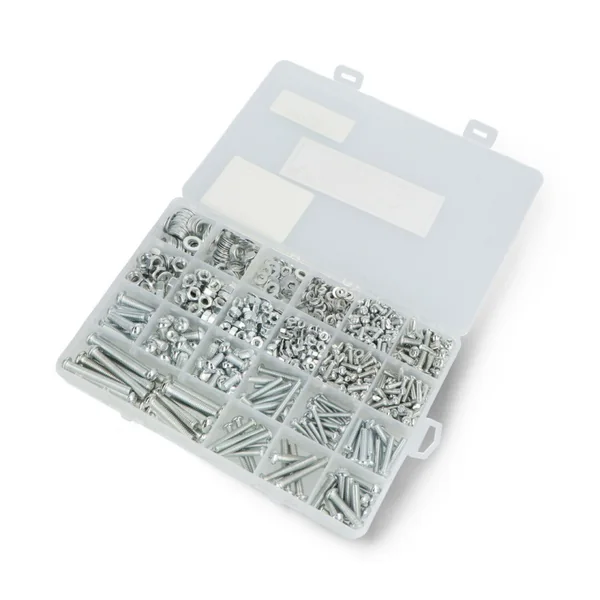
docs/assets/components/photos/fastener-kit.webp
