hvitis/PingPongLauncher/docs/assets/components/photos/geared-motor.webp

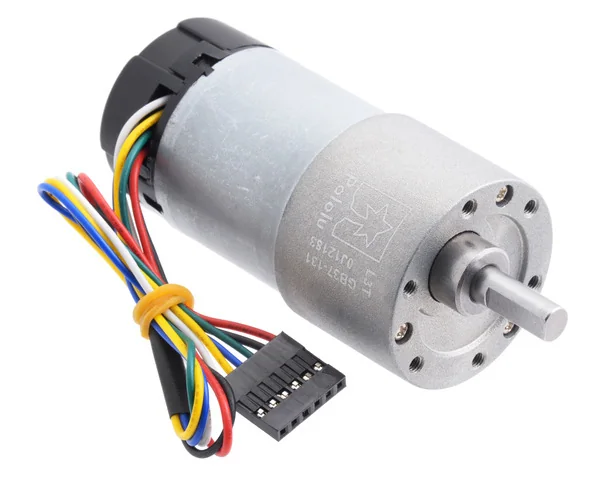
docs/assets/components/photos/geared-motor.webp
