hvitis/PingPongLauncher/docs/assets/components/photos/heat-insert.webp

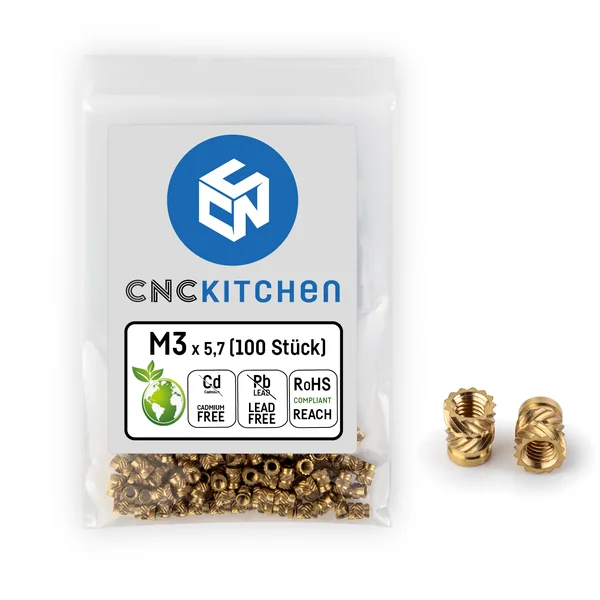
docs/assets/components/photos/heat-insert.webp
