hvitis/PingPongLauncher/docs/assets/components/photos/hex-nuts.webp

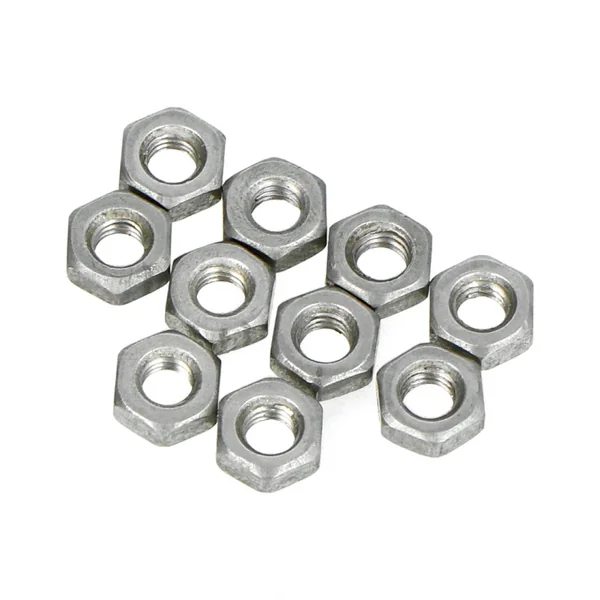
docs/assets/components/photos/hex-nuts.webp
