hvitis/PingPongLauncher/docs/assets/components/photos/hookup-wire.webp

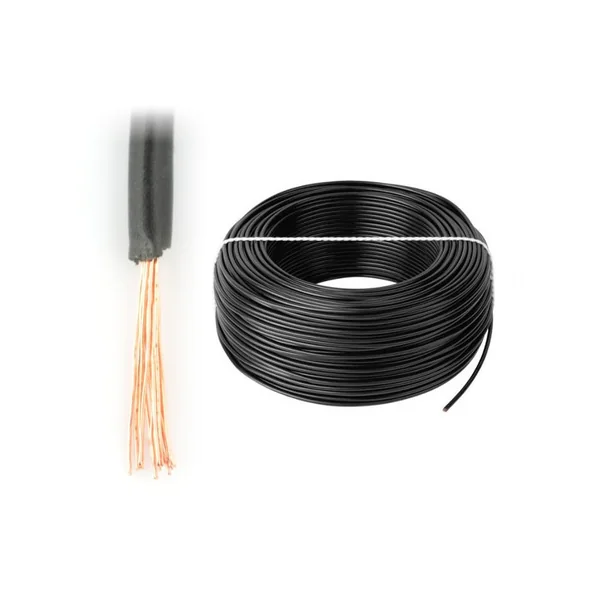
docs/assets/components/photos/hookup-wire.webp
