hvitis/PingPongLauncher/docs/assets/components/photos/launch-motor.webp

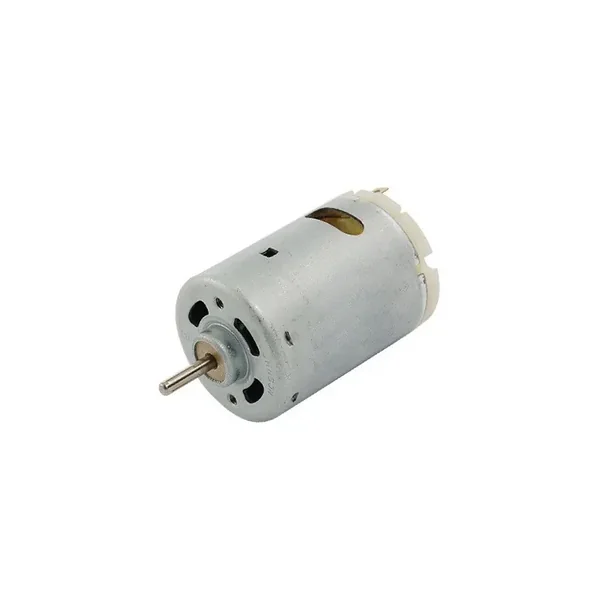
docs/assets/components/photos/launch-motor.webp
