hvitis/PingPongLauncher/docs/assets/components/photos/non-slip-feet.webp

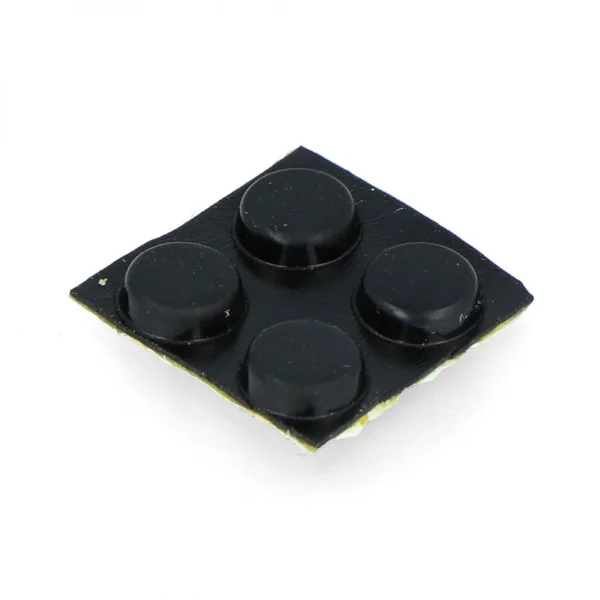
docs/assets/components/photos/non-slip-feet.webp
