hvitis/PingPongLauncher/docs/assets/components/photos/petg-spool.webp

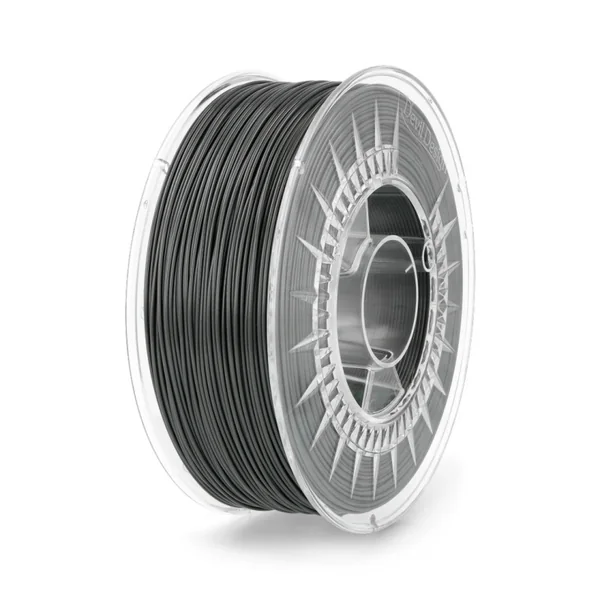
docs/assets/components/photos/petg-spool.webp
