hvitis/PingPongLauncher/docs/assets/components/photos/pwm-controller.webp

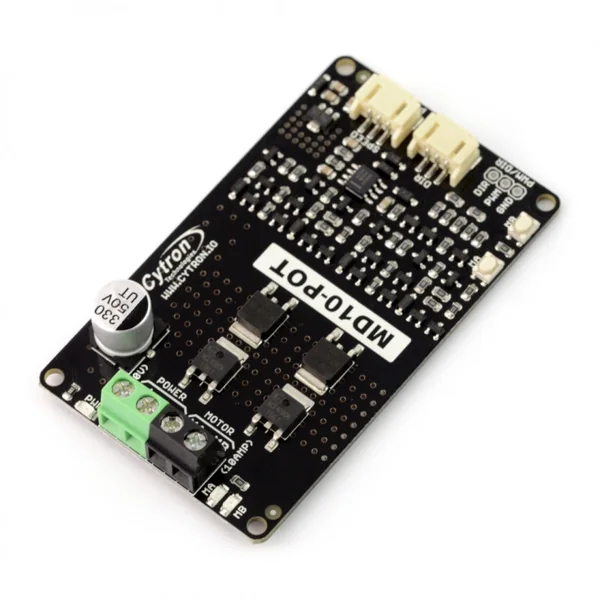
docs/assets/components/photos/pwm-controller.webp
