hvitis/PingPongLauncher/docs/assets/components/photos/self-tapping-screw.webp

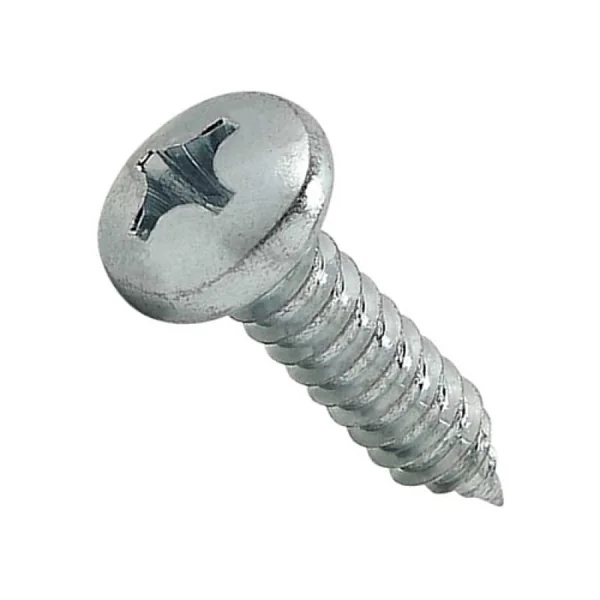
docs/assets/components/photos/self-tapping-screw.webp
