hvitis/PingPongLauncher/docs/assets/components/photos/socket-screws.webp

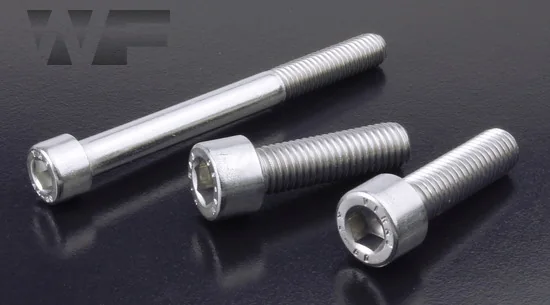
docs/assets/components/photos/socket-screws.webp
