hvitis/PingPongLauncher/docs/assets/components/photos/star-knob.webp

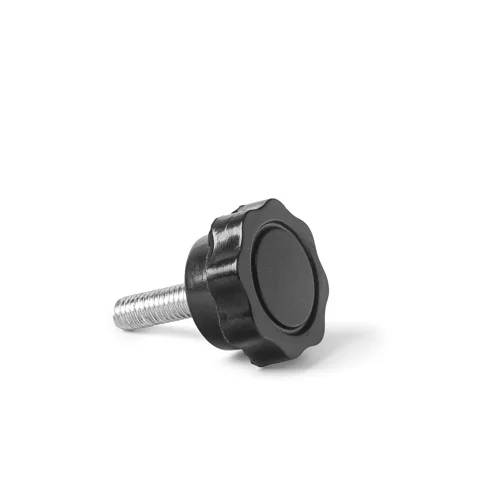
docs/assets/components/photos/star-knob.webp
