hvitis/PingPongLauncher/docs/assets/components/photos/table-tennis-balls.webp

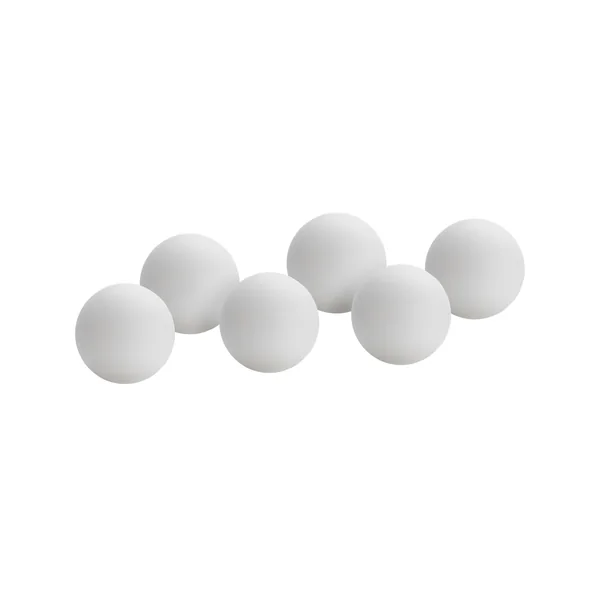
docs/assets/components/photos/table-tennis-balls.webp
