hvitis/PingPongLauncher/docs/assets/components/photos/table-tennis-rubber.webp

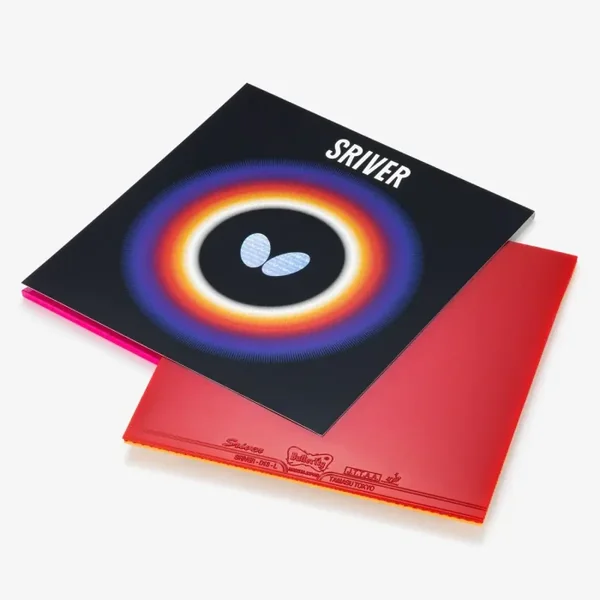
docs/assets/components/photos/table-tennis-rubber.webp
