hvitis/PingPongLauncher/docs/assets/components/photos/toggle-switch.webp

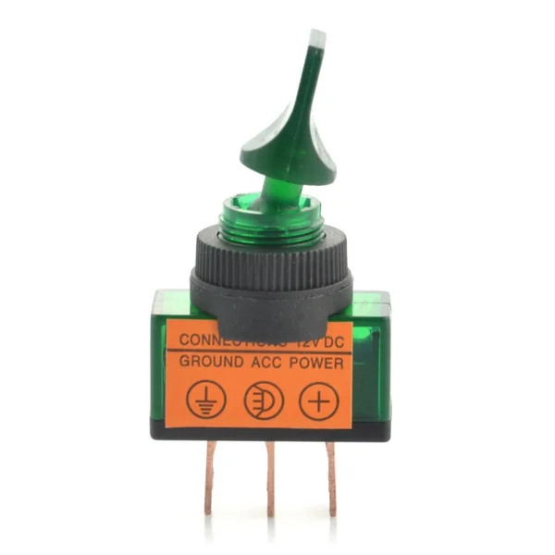
docs/assets/components/photos/toggle-switch.webp
