hvitis/PingPongLauncher/docs/downloads/launcher-assembly.step

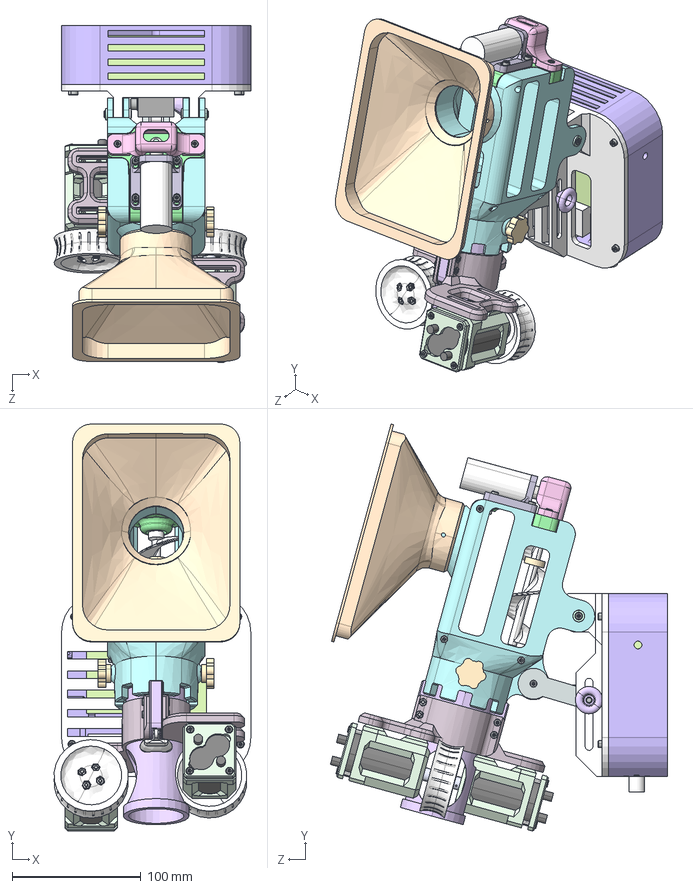
[picture p35: CAD file, 2026-10-26]
docs/downloads/launcher-assembly.step
152.7 x 316.1 x 261.9 mm
底板下层
PWM x 3
端盖-改
电源
550电机模型 x 2
550电机 x 2
法轮盘 x 2
法轮盘及发射盘 x 2
内六角圆柱头螺钉 M3x10 x 22
六角螺母 M3 x 17
动力改
出口管，待改
零件2^测试装配体2 x 2
撑杆改
手旋螺丝 x 2
螺母_有螺母槽的 x 2
螺母 x 2
后盖
复件 零件3^装配体1_发球机
减速电机推进2
涡轮改_直伞齿轮适配
复件 零件4^装配体1_发球机
直伞齿轮、_GB - Straight bevel pinion 1M15PT 12GT 20PA 50FW ---15O10H13.5MD4.0N
直伞齿轮、_2
蝶形螺母
内六角圆柱头螺钉 M5x35
平垫 Φ5
内六角圆柱头螺钉 M3x65 x 3
内六角圆柱头螺钉 M3x18 x 7
内六角圆柱头螺钉 M3x15 x 2
内六角圆柱头螺钉 M3x25 x 2
轴承 x 4
储球
pingpang
qqqqqqqqqq
q
