hvitis/PingPongLauncher/docs/thrower/print/3mf/tray.3mf

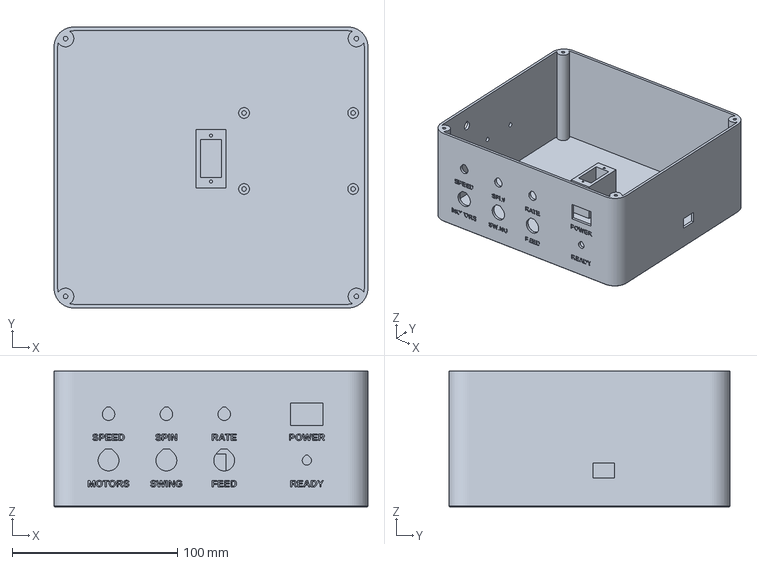
[picture p36: CAD file, 2026-10-29]
docs/thrower/print/3mf/tray.3mf
190.0 x 170.0 x 82.0 mm
