hvitis/PingPongLauncher/docs/thrower/print/a1/spacer_parts.3mf

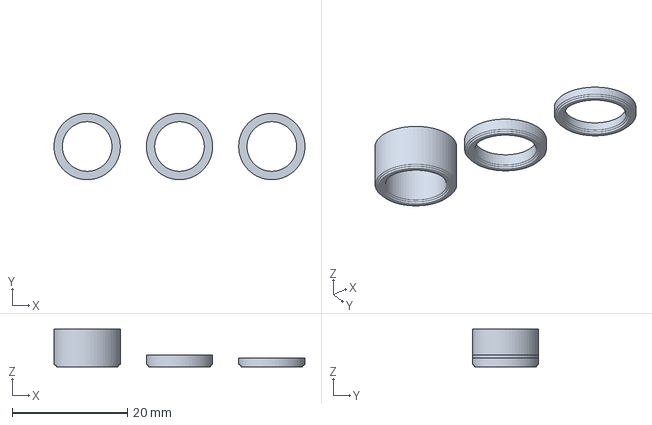
[picture p37: CAD file, 2026-10-29]
docs/thrower/print/a1/spacer_parts.3mf
43.5 x 11.5 x 6.50 mm
