hvitis/PingPongLauncher/docs/thrower/web/models/swing_servo.stl

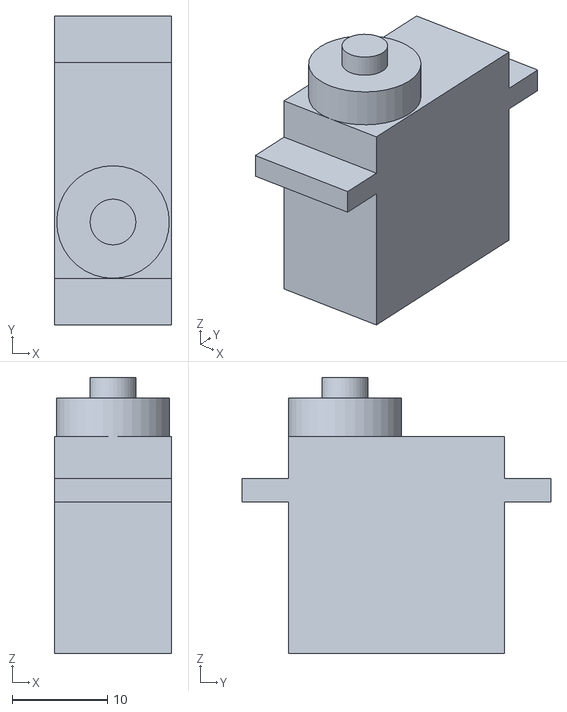
[picture p38: CAD file, 2026-10-29]
docs/thrower/web/models/swing_servo.stl
12.3 x 32.4 x 29.0
