hvitis/PingPongLauncher/docs/downloads/launcher-english.3mf

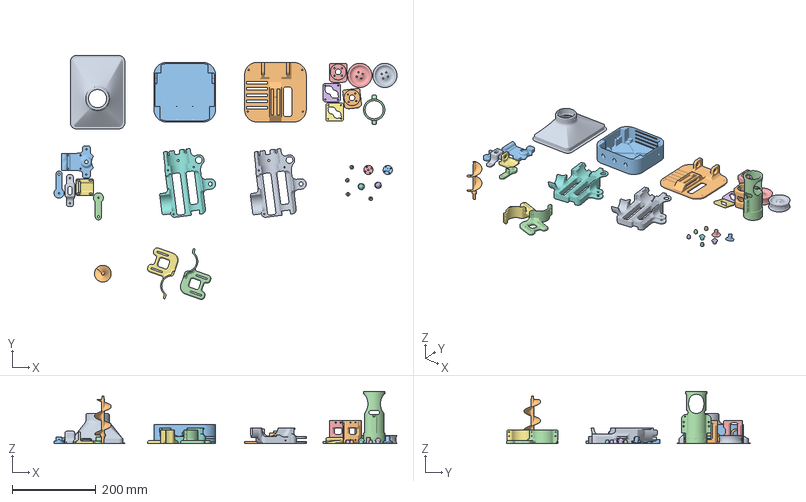
[picture p39: CAD file, 2026-10-26]
docs/downloads/launcher-english.3mf
816.7 x 581.1 x 125.0 mm
Hopper
Feed screw
Wheel flange A
Launch support A
Wheel flange B
Bevel gear
Launch support B
Bevel pinion
Launch wheel A
Captive nut knob A
Rear cover
Captive nut knob B
Launch wheel B
Printed knob A
Feed motor mount
Printed knob B
Rear support
Motor mount 1A
Tilt linkage A
Tilt linkage B
Motor mount 1B
Motor mount 2A
Motor mount 2B
Main body half A
Main body half B
Base lid
Base enclosure
Outlet tube - revision pending
