hvitis/PingPongLauncher/docs/thrower/print/3mf/feed_tube.3mf

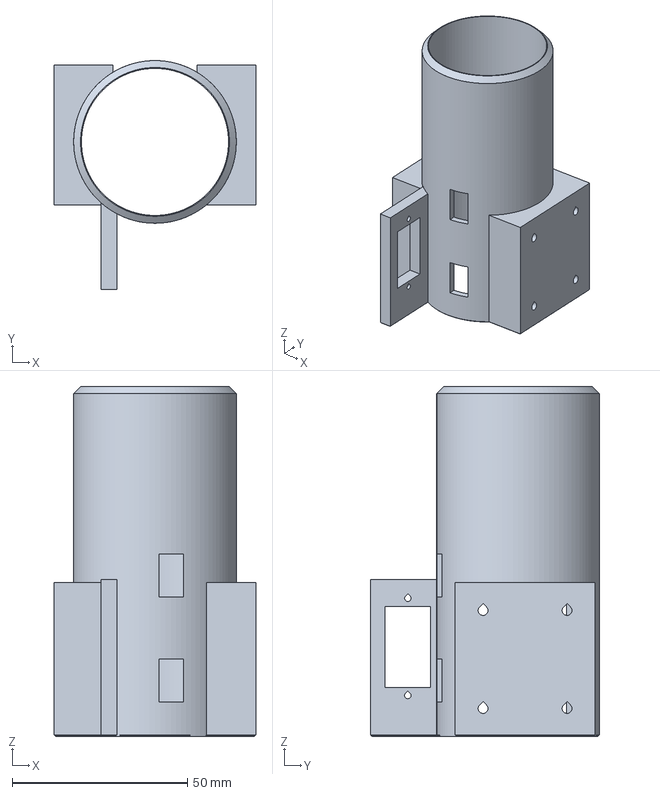
[picture p40: CAD file, 2026-10-29]
docs/thrower/print/3mf/feed_tube.3mf
57.6 x 65.4 x 100.0 mm
