hvitis/PingPongLauncher/docs/thrower/print/a1/wheel_hub.3mf

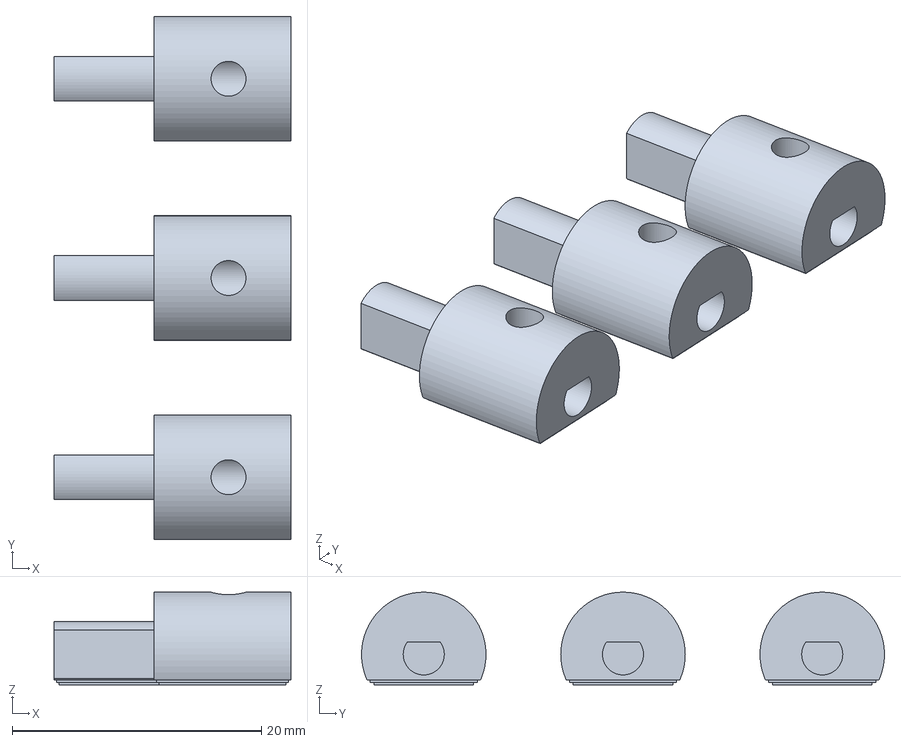
[picture p41: CAD file, 2026-10-29]
docs/thrower/print/a1/wheel_hub.3mf
19.0 x 42.0 x 7.45 mm
