hvitis/PingPongLauncher/docs/thrower/print/3mf/knob_pot.3mf

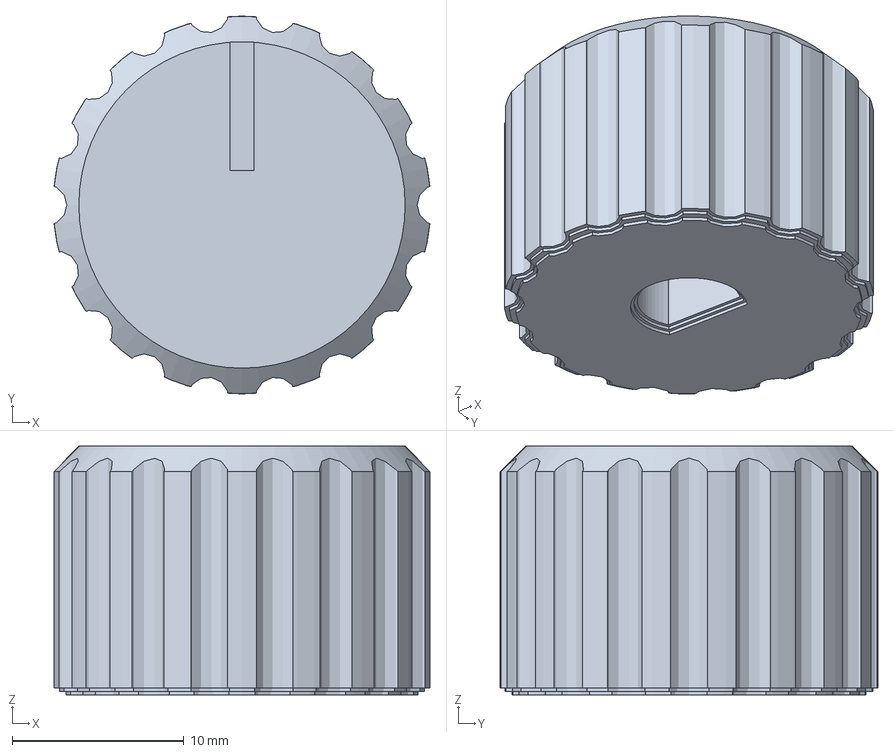
[picture p42: CAD file, 2026-10-29]
docs/thrower/print/3mf/knob_pot.3mf
21.9 x 22.0 x 14.5 mm
