hvitis/PingPongLauncher/docs/thrower/print/a1/coupler.3mf

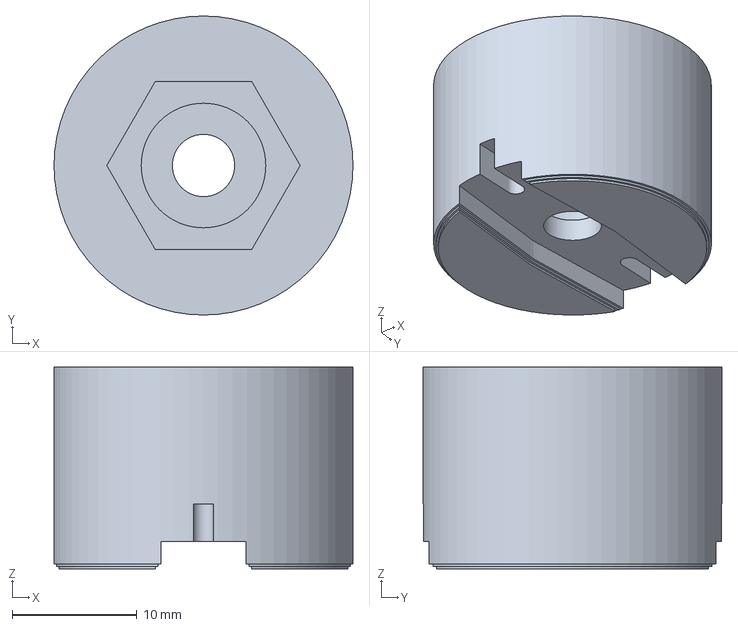
[picture p43: CAD file, 2026-10-29]
docs/thrower/print/a1/coupler.3mf
24.0 x 24.0 x 16.2 mm
