hvitis/PingPongLauncher/docs/thrower/web/models/tyre_bot.stl

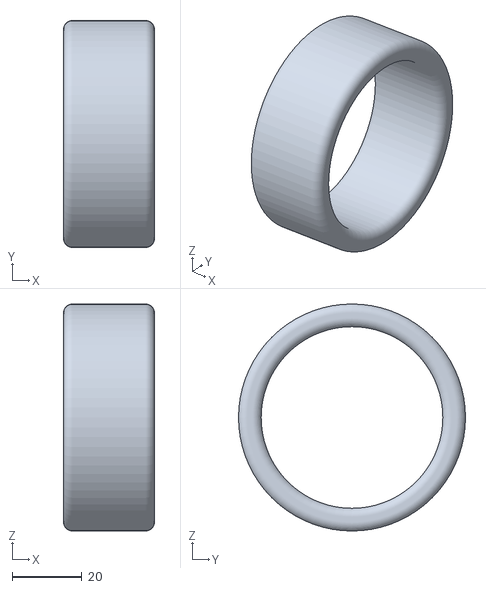
[picture p44: CAD file, 2026-10-29]
docs/thrower/web/models/tyre_bot.stl
26.0 x 65.0 x 65.0
