hvitis/PingPongLauncher/docs/thrower/print/3mf/motor_clamp.3mf

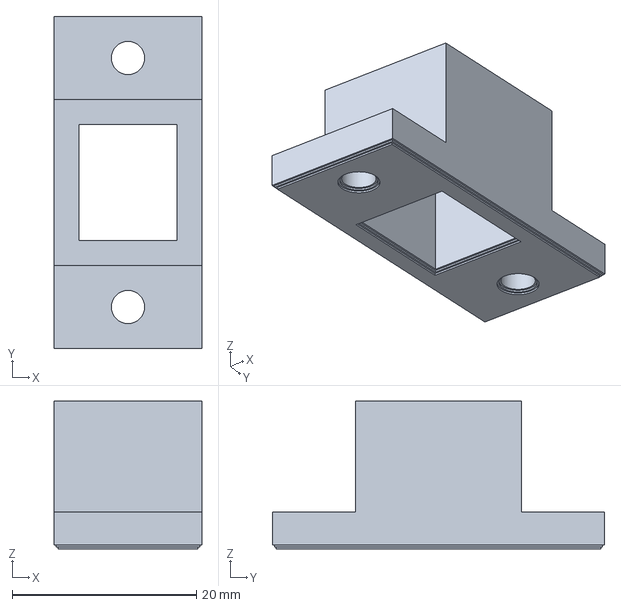
[picture p45: CAD file, 2026-10-29]
docs/thrower/print/3mf/motor_clamp.3mf
16.0 x 36.0 x 16.0 mm
