hvitis/PingPongLauncher/docs/thrower/print/a1/knob_pot.3mf

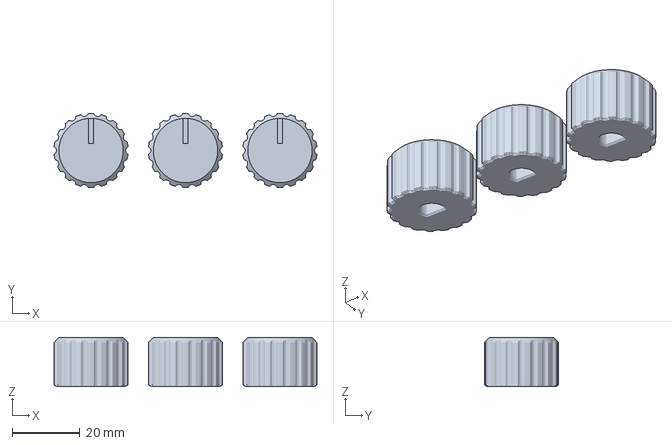
[picture p46: CAD file, 2026-10-29]
docs/thrower/print/a1/knob_pot.3mf
77.7 x 22.0 x 14.5 mm
