hvitis/PingPongLauncher/docs/thrower/web/models/head_left.stl

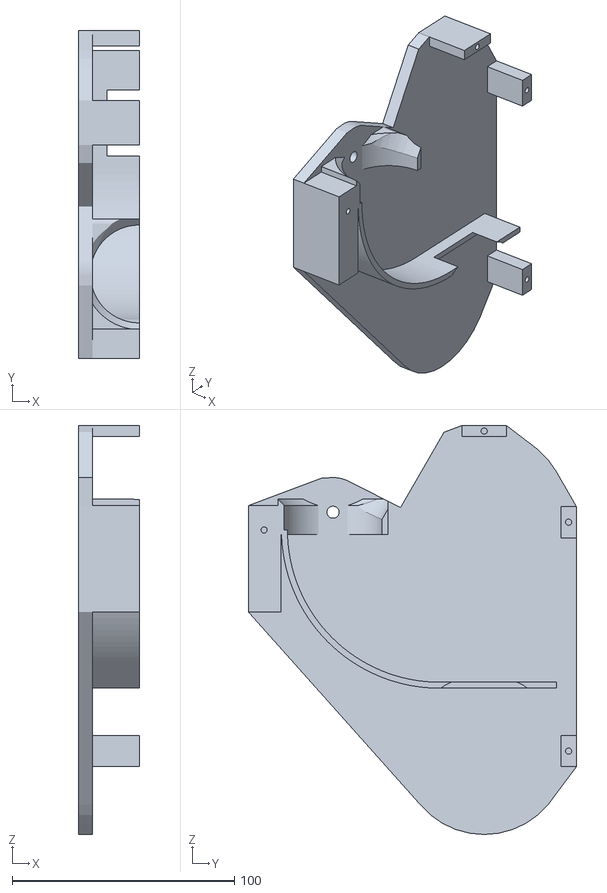
[picture p47: CAD file, 2026-10-29]
docs/thrower/web/models/head_left.stl
27.3 x 147.5 x 184.0
