hvitis/PingPongLauncher/docs/thrower/print/a1/lid.3mf

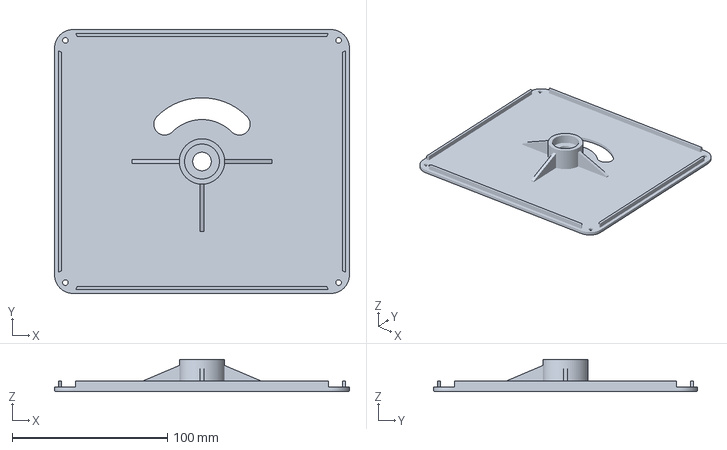
[picture p48: CAD file, 2026-10-29]
docs/thrower/print/a1/lid.3mf
190.0 x 170.0 x 20.9 mm
