hvitis/PingPongLauncher/docs/thrower/print/a1/hopper.3mf

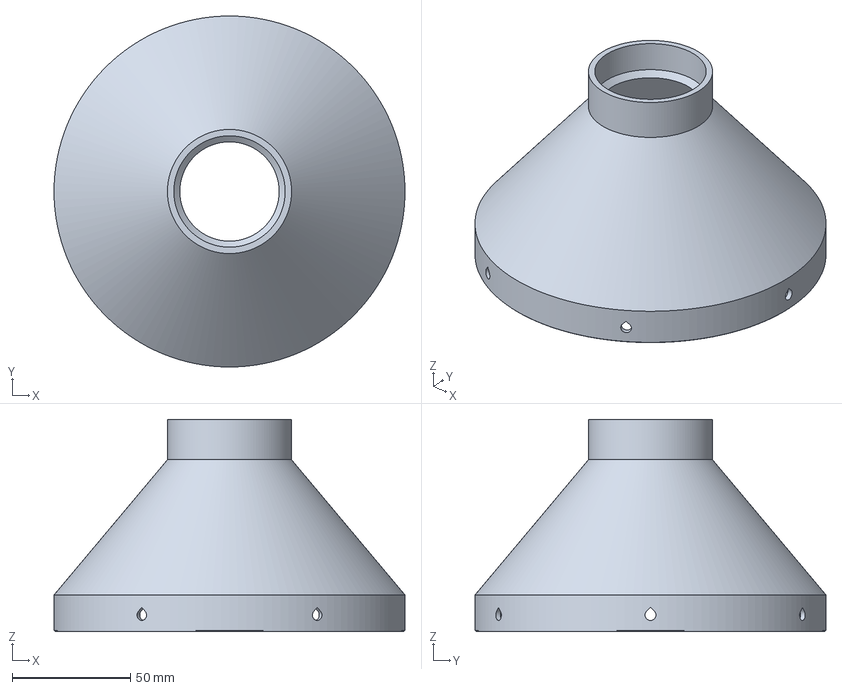
[picture p49: CAD file, 2026-10-29]
docs/thrower/print/a1/hopper.3mf
148.5 x 148.5 x 89.8 mm
