hvitis/PingPongLauncher/docs/thrower/web/models/loose_board.stl

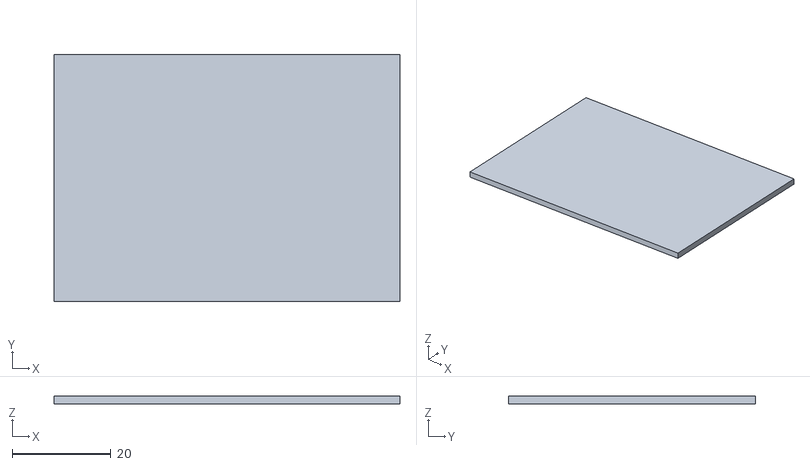
[picture p50: CAD file, 2026-10-29]
docs/thrower/web/models/loose_board.stl
70.0 x 50.0 x 1.60
