hvitis/PingPongLauncher/docs/thrower/print/3mf/poc_base.3mf

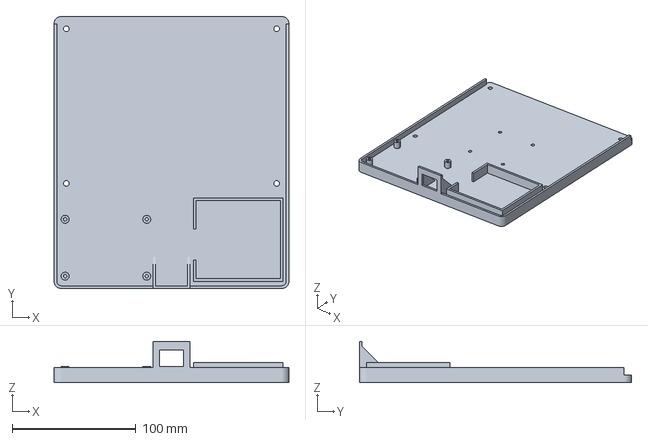
[picture p51: CAD file, 2026-10-29]
docs/thrower/print/3mf/poc_base.3mf
190.0 x 220.0 x 33.2 mm
