hvitis/PingPongLauncher/docs/thrower/web/models/panel.stl

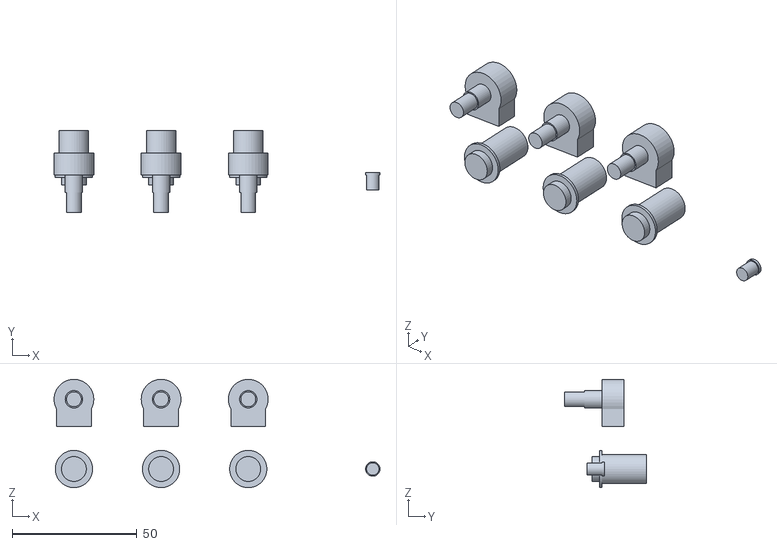
[picture p52: CAD file, 2026-10-29]
docs/thrower/web/models/panel.stl
130.9 x 33.0 x 43.5
