hvitis/PingPongLauncher/docs/thrower/print/3mf/cheek_left.3mf

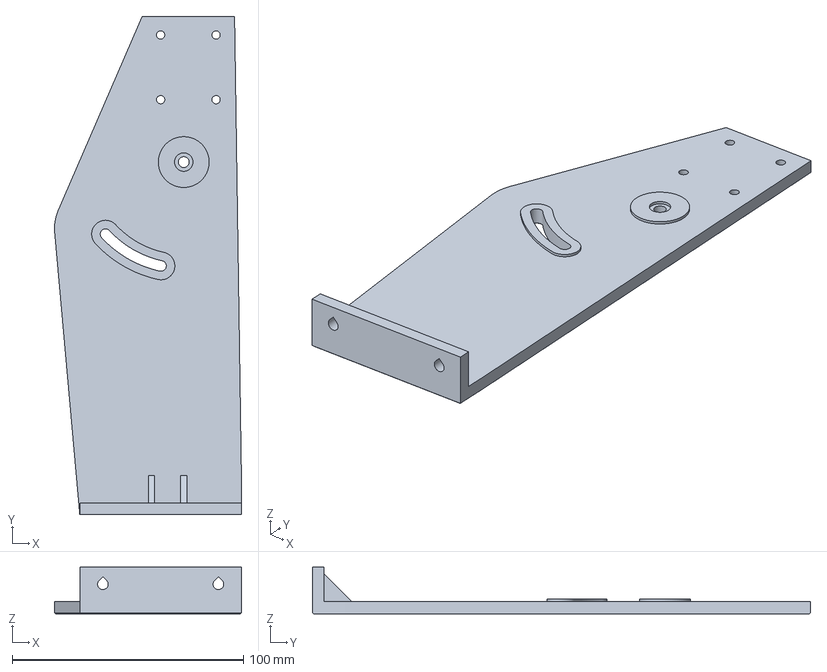
[picture p53: CAD file, 2026-10-29]
docs/thrower/print/3mf/cheek_left.3mf
80.9 x 215.5 x 20.2 mm
