hvitis/PingPongLauncher/docs/thrower/print/a1/turret.3mf

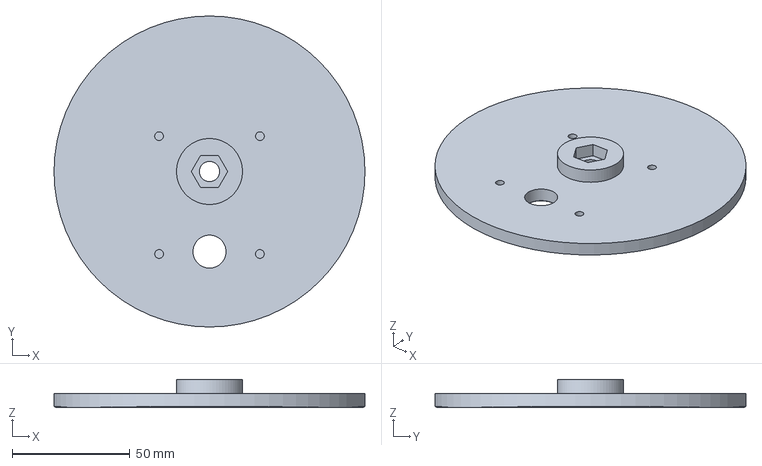
[picture p54: CAD file, 2026-10-29]
docs/thrower/print/a1/turret.3mf
132.0 x 132.0 x 12.0 mm
