hvitis/PingPongLauncher/docs/thrower/web/models/balls.stl

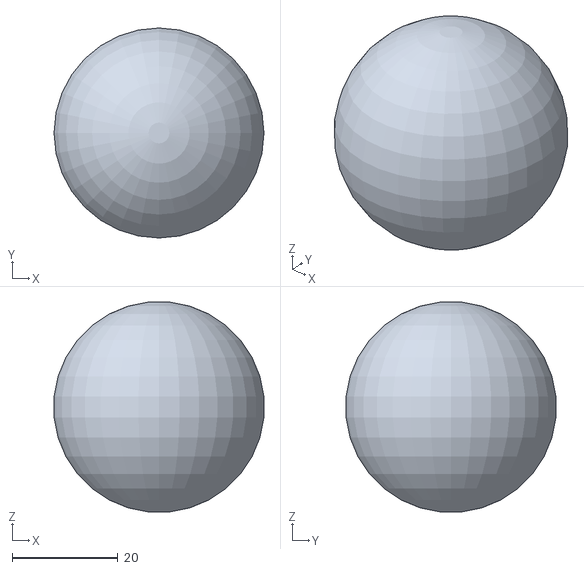
[picture p55: CAD file, 2026-10-29]
docs/thrower/web/models/balls.stl
39.8 x 39.8 x 39.8
