hvitis/PingPongLauncher/docs/thrower/print/a1/rocker.3mf

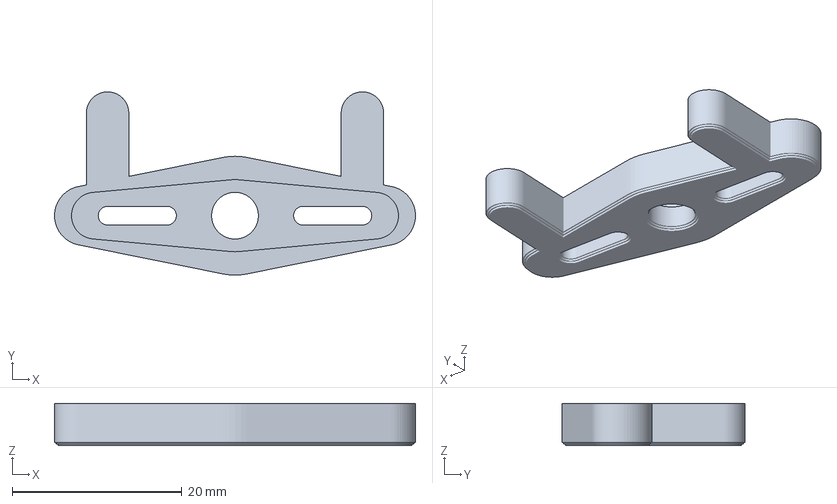
[picture p56: CAD file, 2026-10-29]
docs/thrower/print/a1/rocker.3mf
42.5 x 21.6 x 5.00 mm
