hvitis/PingPongLauncher/docs/thrower/web/models/poc_driver.stl

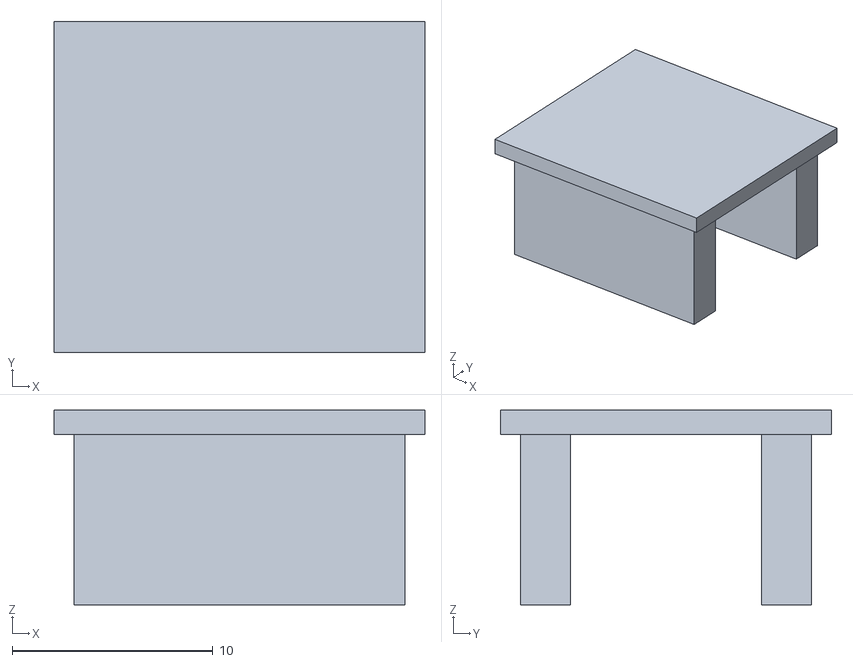
[picture p57: CAD file, 2026-10-29]
docs/thrower/web/models/poc_driver.stl
18.5 x 16.5 x 9.70
