hvitis/PingPongLauncher/docs/thrower/print/3mf/wheel_hub.3mf

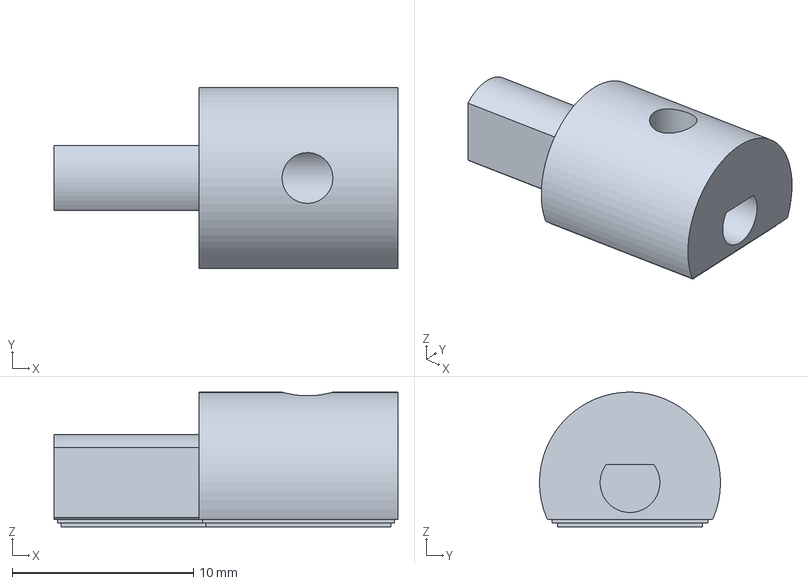
[picture p58: CAD file, 2026-10-29]
docs/thrower/print/3mf/wheel_hub.3mf
19.0 x 10.0 x 7.45 mm
