hvitis/PingPongLauncher/docs/thrower/web/models/motors.stl

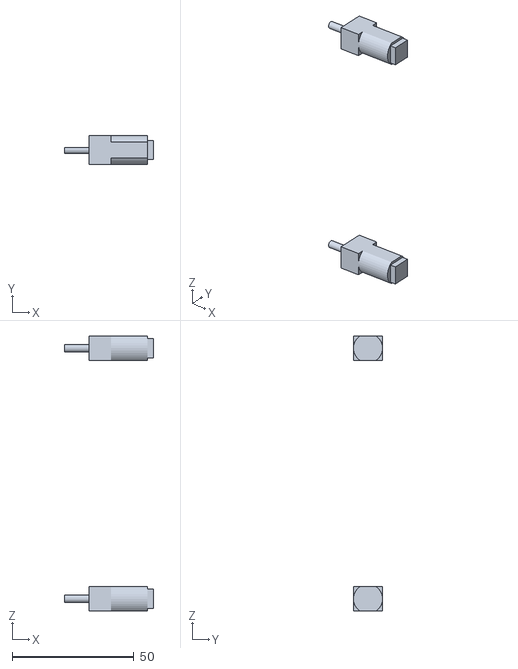
[picture p59: CAD file, 2026-10-29]
docs/thrower/web/models/motors.stl
36.5 x 12.0 x 113.0
