hvitis/PingPongLauncher/docs/thrower/web/models/loose_battery.stl

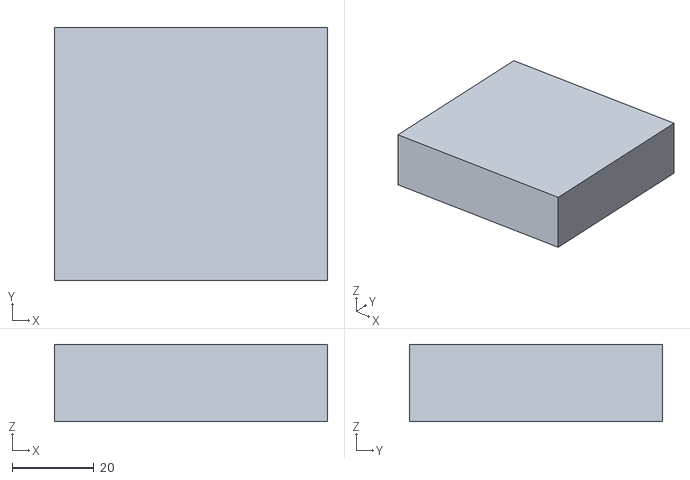
[picture p60: CAD file, 2026-10-29]
docs/thrower/web/models/loose_battery.stl
67.0 x 62.0 x 19.0
