hvitis/PingPongLauncher/docs/thrower/print/3mf/knob_lock.3mf

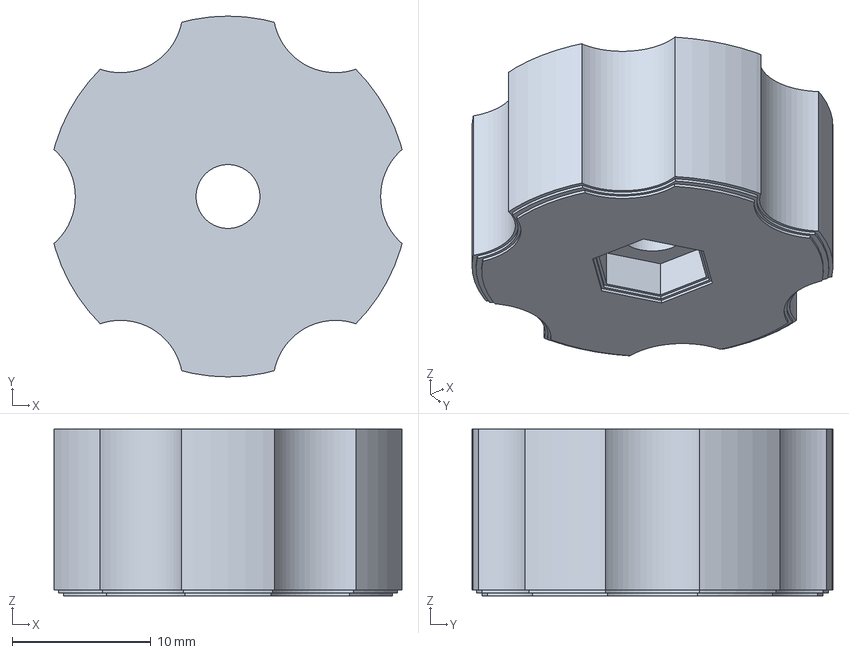
[picture p61: CAD file, 2026-10-29]
docs/thrower/print/3mf/knob_lock.3mf
25.1 x 26.0 x 12.0 mm
