hvitis/PingPongLauncher/docs/thrower/web/models/bearings.stl

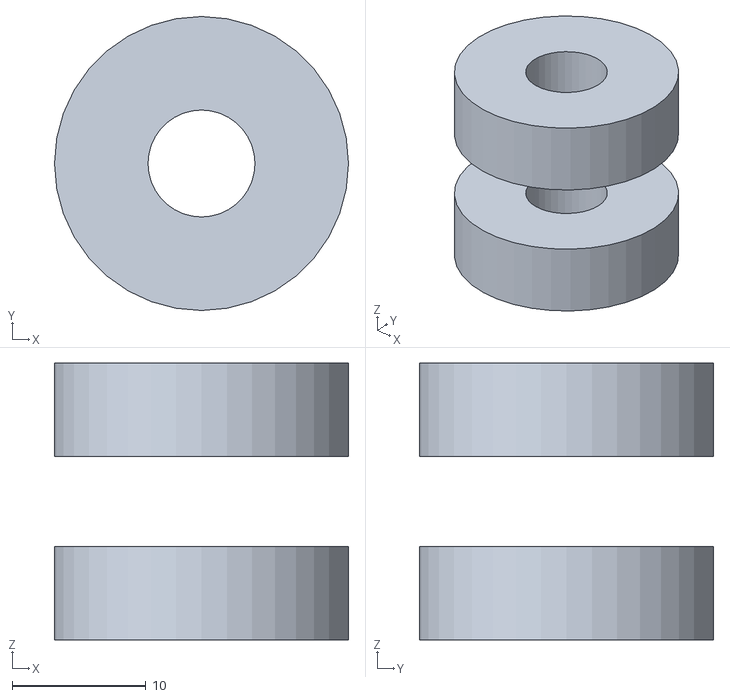
[picture p62: CAD file, 2026-10-29]
docs/thrower/web/models/bearings.stl
22.0 x 22.0 x 20.7
