hvitis/PingPongLauncher/docs/thrower/print/a1/motor_clamp.3mf

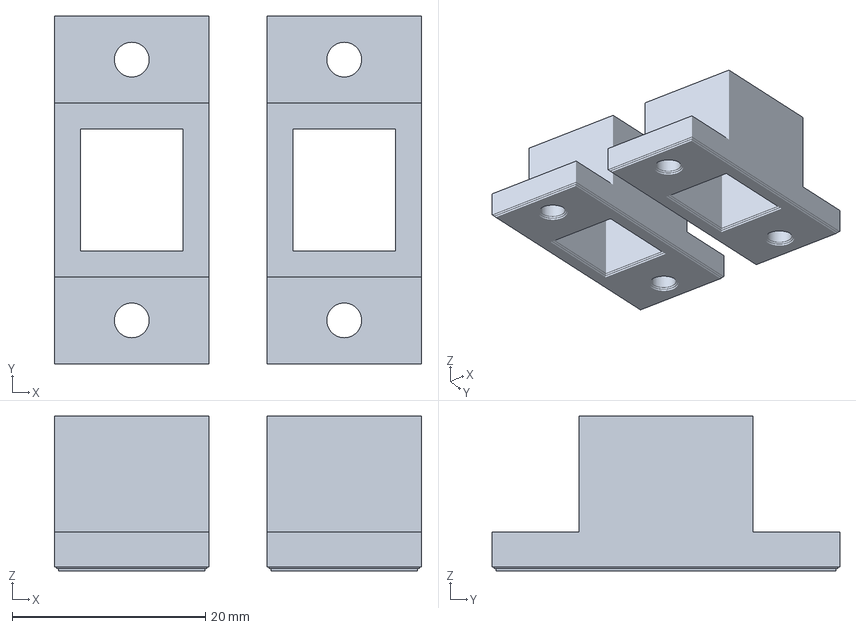
[picture p63: CAD file, 2026-10-29]
docs/thrower/print/a1/motor_clamp.3mf
38.0 x 36.0 x 16.0 mm
