hvitis/PingPongLauncher/docs/thrower/web/models/cheeks.stl

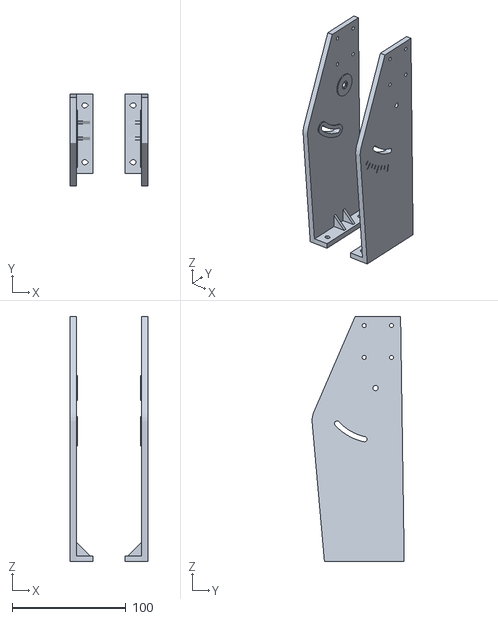
[picture p64: CAD file, 2026-10-29]
docs/thrower/web/models/cheeks.stl
68.4 x 80.9 x 215.5
