hvitis/PingPongLauncher/docs/thrower/print/a1/knob_lock.3mf

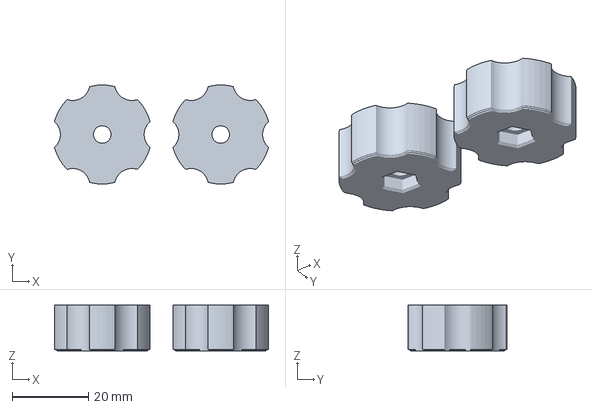
[picture p65: CAD file, 2026-10-29]
docs/thrower/print/a1/knob_lock.3mf
56.2 x 26.0 x 12.0 mm
