hvitis/PingPongLauncher/docs/thrower/web/models/panel_knobs.stl

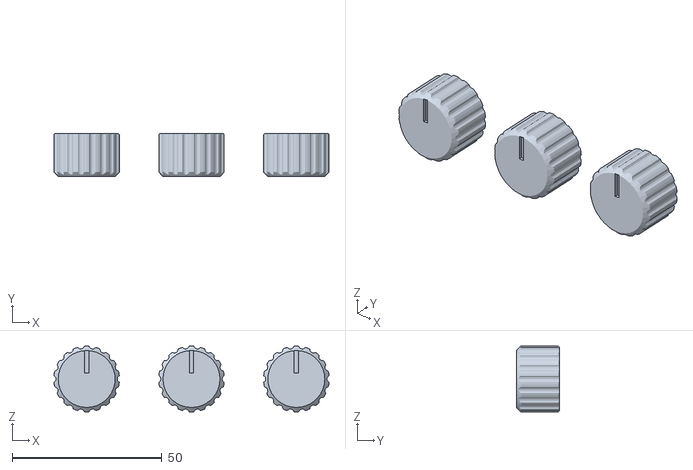
[picture p66: CAD file, 2026-10-29]
docs/thrower/web/models/panel_knobs.stl
91.8 x 14.5 x 22.0
