hvitis/PingPongLauncher/docs/thrower/web/models/rim_top.stl

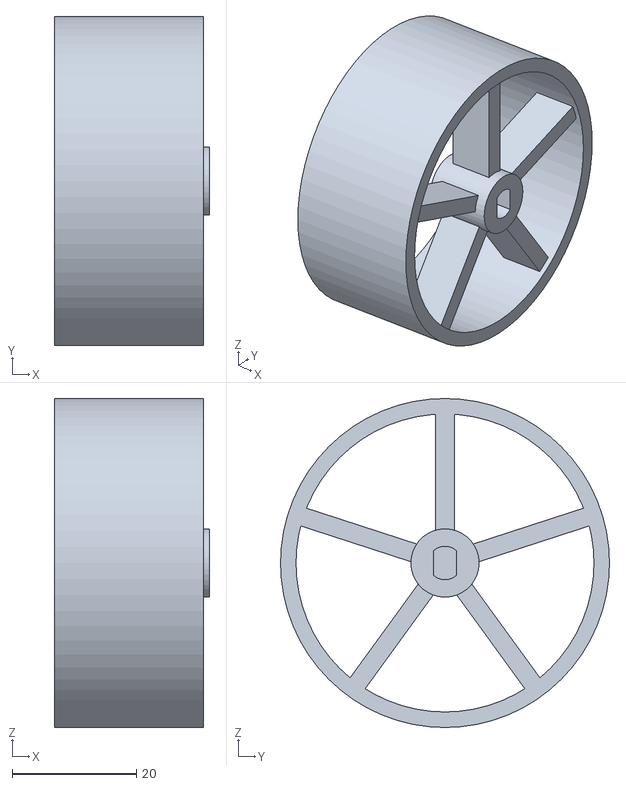
[picture p67: CAD file, 2026-10-29]
docs/thrower/web/models/rim_top.stl
25.0 x 53.0 x 53.0
