hvitis/PingPongLauncher/docs/thrower/web/models/hub_bot.stl

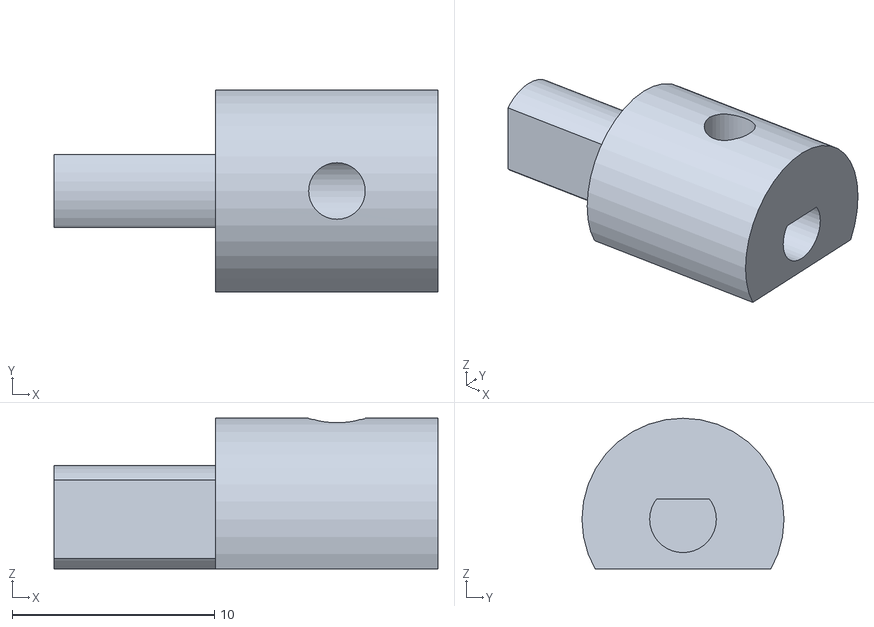
[picture p68: CAD file, 2026-10-29]
docs/thrower/web/models/hub_bot.stl
19.0 x 10.0 x 7.45
