hvitis/PingPongLauncher/docs/thrower/web/models/poc_switch.stl

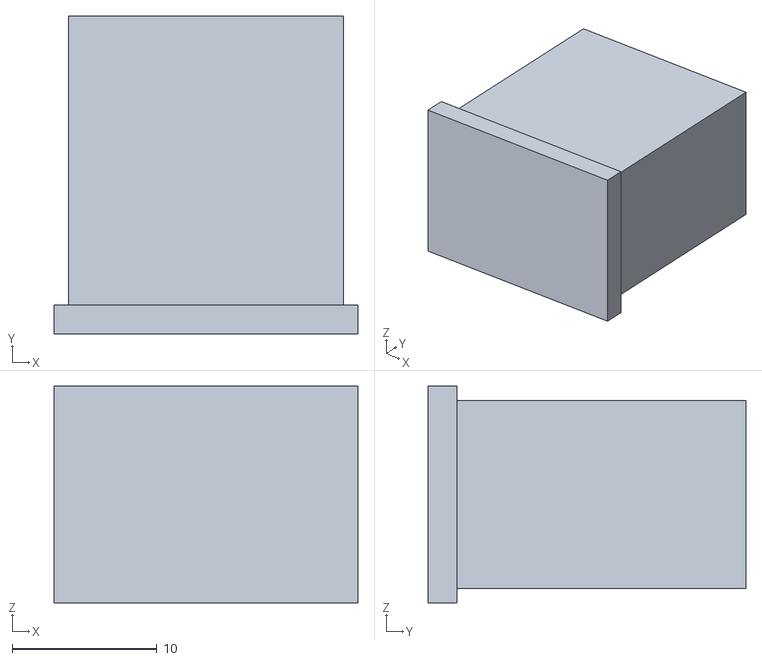
[picture p69: CAD file, 2026-10-29]
docs/thrower/web/models/poc_switch.stl
21.0 x 22.0 x 15.0
