hvitis/PingPongLauncher/docs/thrower/web/models/lock_knobs.stl

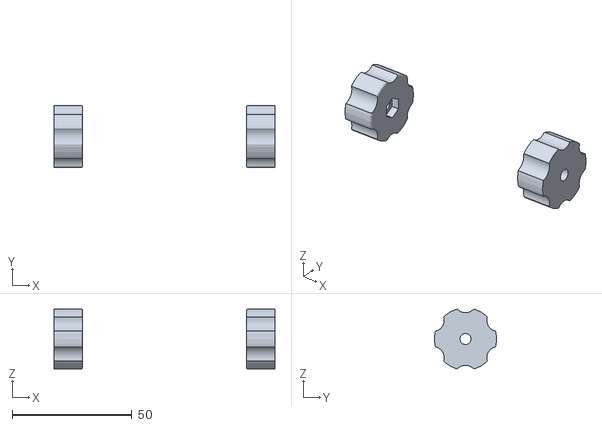
[picture p70: CAD file, 2026-10-29]
docs/thrower/web/models/lock_knobs.stl
92.4 x 26.0 x 25.0
