hvitis/PingPongLauncher/docs/thrower/web/models/poc_pico.stl

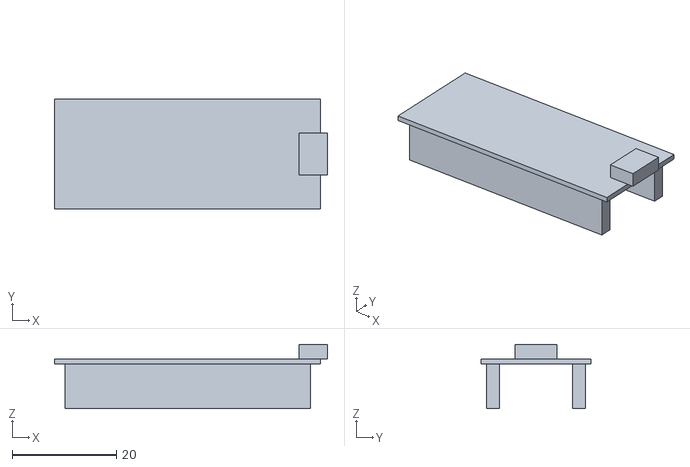
[picture p71: CAD file, 2026-10-29]
docs/thrower/web/models/poc_pico.stl
52.3 x 21.0 x 12.3
