hvitis/PingPongLauncher/docs/thrower/web/models/clamps.stl

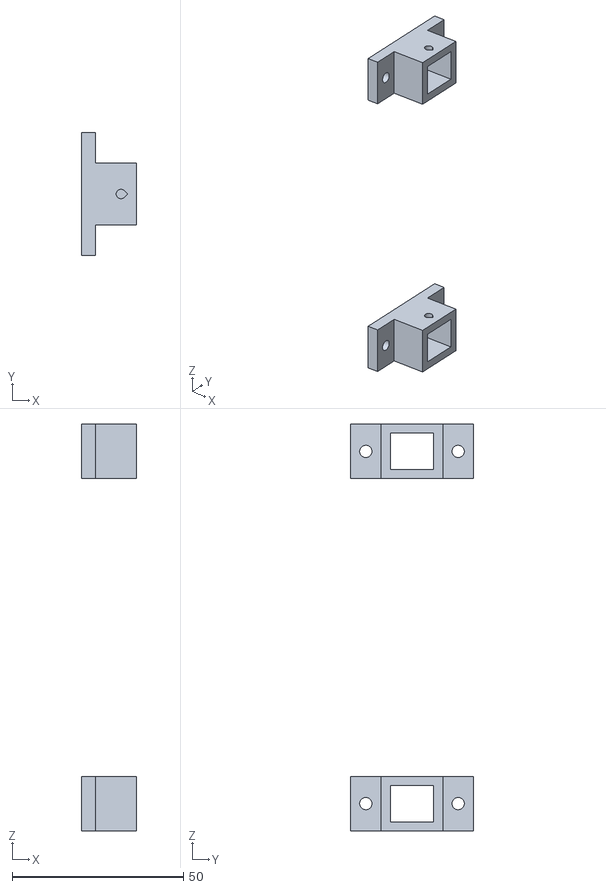
[picture p72: CAD file, 2026-10-29]
docs/thrower/web/models/clamps.stl
16.0 x 36.0 x 119.0
