hvitis/PingPongLauncher/(list of files, cad)

Other CAD files:
docs/thrower/print/3mf/head_right.3mf
docs/thrower/web/models/lid.stl
docs/thrower/print/3mf/coupler.3mf
docs/thrower/print/a1/feed_tube.3mf
docs/thrower/print/a1/tray.3mf
docs/thrower/web/models/coupler.stl
docs/thrower/print/3mf/lid.3mf
docs/thrower/print/3mf/turret.3mf
docs/thrower/print/a1/cheek_right.3mf
docs/thrower/print/3mf/hopper.3mf
docs/thrower/print/a1/head_left.3mf
docs/thrower/print/3mf/rocker.3mf
docs/thrower/print/a1/head_right.3mf
docs/thrower/web/models/board.stl
docs/thrower/print/a1/poc_base.3mf
docs/thrower/print/3mf/cheek_right.3mf
docs/thrower/print/3mf/head_left.3mf
docs/thrower/web/models/rocker.stl
docs/thrower/print/3mf/spacer_parts.3mf
docs/thrower/print/a1/cheek_left.3mf
docs/thrower/web/models/turret.stl
docs/thrower/web/models/hub_top.stl
docs/thrower/web/models/hopper.stl
docs/thrower/web/models/poc_battery.stl
docs/thrower/web/models/loose_switch.stl
docs/thrower/web/models/tyre_top.stl
docs/thrower/web/models/feed_servo.stl
docs/thrower/web/models/panel_switch.stl
docs/thrower/web/models/driver.stl
docs/thrower/web/models/feed_tube.stl
docs/thrower/web/models/battery.stl
docs/thrower/web/models/poc_base.stl
docs/thrower/web/models/tray.stl
docs/thrower/web/models/loose_driver.stl
docs/thrower/web/models/pico.stl
docs/thrower/web/models/rim_bot.stl
docs/thrower/web/models/head_right.stl
docs/thrower/web/models/poc_board.stl
docs/thrower/web/models/loose_pico.stl
docs/thrower/print/stl/cheek_left.stl
docs/thrower/print/stl/cheek_right.stl
docs/thrower/print/stl/coupler.stl
docs/thrower/print/stl/feed_tube.stl
docs/thrower/print/stl/head_left.stl
docs/thrower/print/stl/head_right.stl
docs/thrower/print/stl/hopper.stl
docs/thrower/print/stl/knob_lock.stl
docs/thrower/print/stl/knob_pot.stl
docs/thrower/print/stl/lid.stl
docs/thrower/print/stl/motor_clamp.stl
docs/thrower/print/stl/poc_base.stl
docs/thrower/print/stl/rocker.stl
docs/thrower/print/stl/spacer_parts.stl
docs/thrower/print/stl/tray.stl
docs/thrower/print/stl/turret.stl
docs/thrower/print/stl/wheel_hub.stl
docs/thrower/web/models/bolt.stl
