hvitis/PingPongLauncher/docs/thrower/wiring.html

Whole rig Board close-up Part names

← Back to the viewer

# Phase 1 wiring in 3D

Each coloured cable joins exactly the two points it touches. Click a step to light up only its cables, or click one cable to follow it alone. Drag to turn the view, scroll to zoom, and hover anything to see what it is.

The colours are only a guide to tell the cables apart. Any colour works, but keep red for + and black for −. Phase 2 uses exactly the same circuit, screwed down on the bench plate.

On the perfboard, a cable drawn to a pin or leg goes into the hole right next to it. Underneath, bend its bare end against that pin and solder the two together.

← → All cables
