hvitis/PingPongLauncher/docs/downloads/mobile01-control-breakout.kicad_pcb

## KiCad design docs/downloads/mobile01-control-breakout.kicad_pcb (2026-10-29)

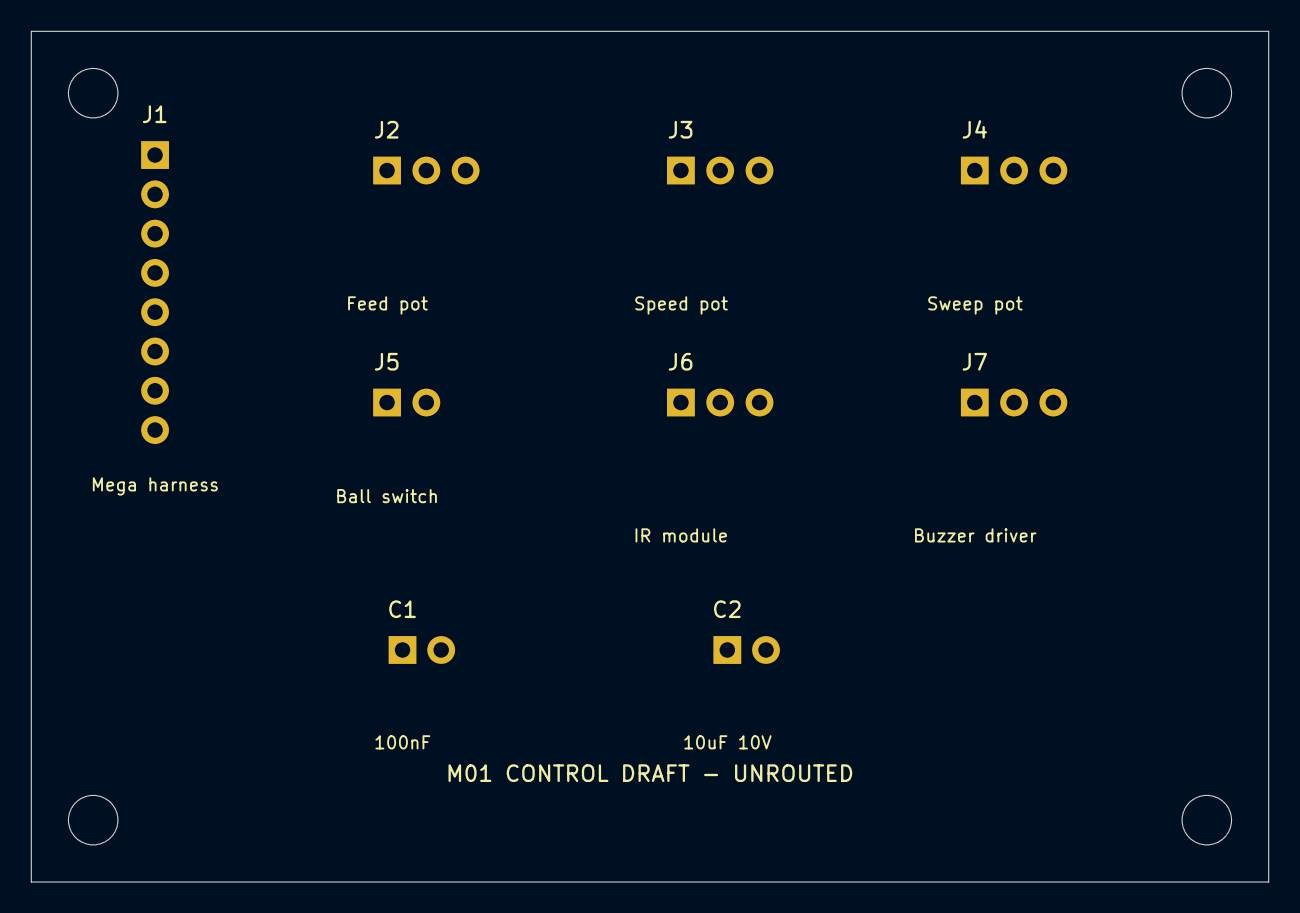
[picture p78: board mobile01-control-breakout.kicad_pcb from above]

Board: 2 copper layers, 80.0 x 55.0 mm, 9 parts (0 on the bottom side), 8 nets, no tracks yet.

Parts:
C1: 100nF; C_Disc_D5.0mm_W2.5mm_P2.50mm
C2: 10uF 10V; CP_Radial_D5.0mm_P2.50mm
J1: Mega harness; PinHeader_1x08_P2.54mm_Vertical
J2: Feed pot; PinHeader_1x03_P2.54mm_Vertical
J3: Speed pot; PinHeader_1x03_P2.54mm_Vertical
J4: Sweep pot; PinHeader_1x03_P2.54mm_Vertical
J5: Ball switch; PinHeader_1x02_P2.54mm_Vertical
J6: IR module; PinHeader_1x03_P2.54mm_Vertical
J7: Buzzer driver; PinHeader_1x03_P2.54mm_Vertical

Connections:
+5V_LOGIC: C1.1, C2.1, J1.2, J2.3, J3.3, J4.3, J6.2, J7.2
BALL_D22: J1.6, J5.2
FEED_A0: J1.3, J2.2
GND: C1.2, C2.2, J1.1, J2.1, J3.1, J4.1, J5.1, J6.1, J7.1
IR_D24: J1.7, J6.3
SPEED_A1: J1.4, J3.2
SWEEP_A2: J1.5, J4.2
TONE_D26: J1.8, J7.3
