hvitis/PingPongLauncher/docs/downloads/hien-servo-breakout.kicad_pcb

## KiCad design docs/downloads/hien-servo-breakout.kicad_pcb (2026-10-29)

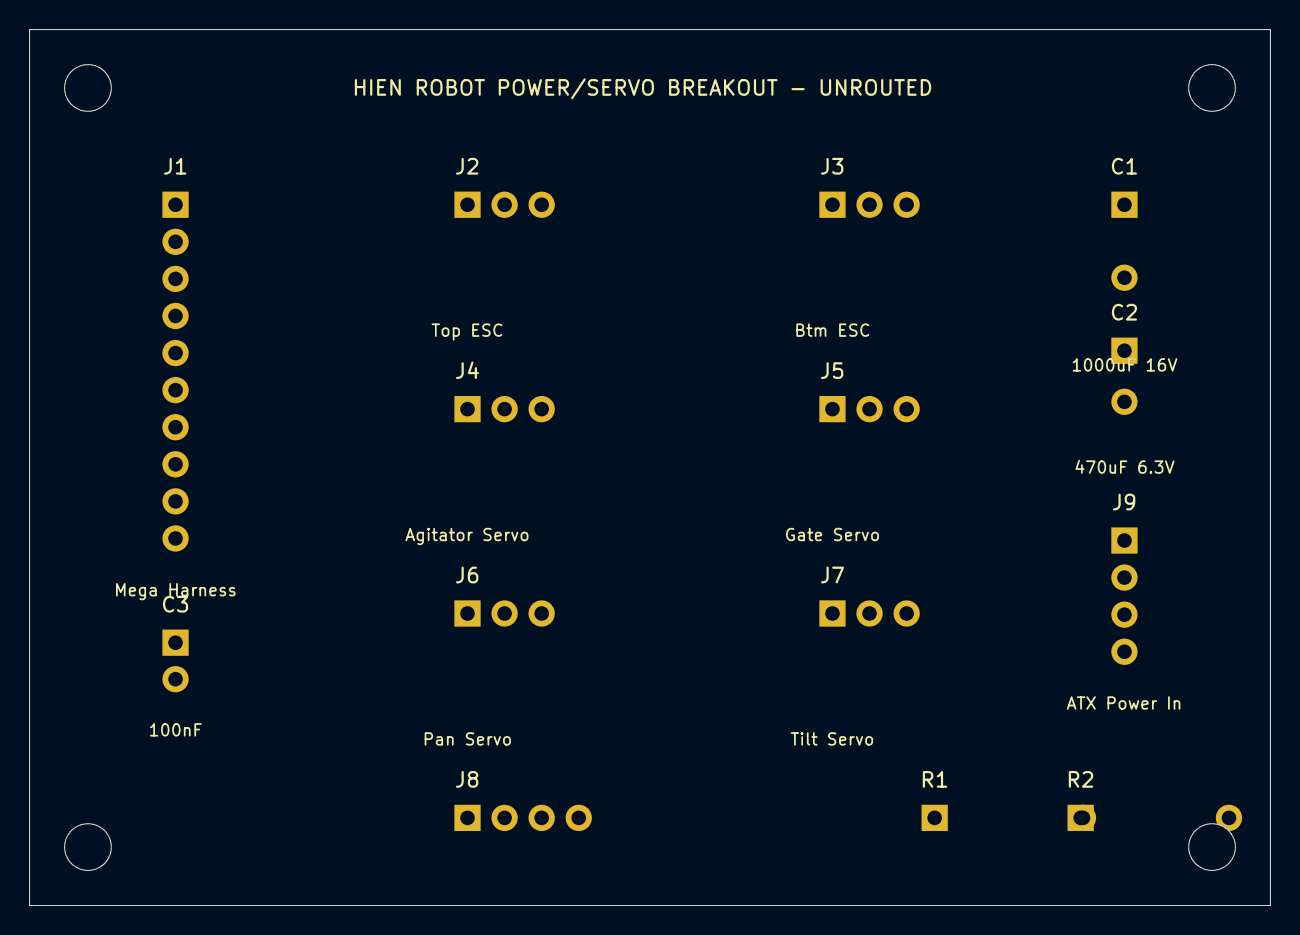
[picture p79: board hien-servo-breakout.kicad_pcb from above]

Board: 2 copper layers, 85.0 x 60.0 mm, 14 parts (0 on the bottom side), 13 nets, no tracks yet.

Parts:
C1: 1000uF 16V; CP_Radial_D10.0mm_P5.00mm
C2: 470uF 6.3V; CP_Radial_D8.0mm_P3.50mm
C3: 100nF; C_Disc_D5.0mm_W2.5mm_P2.50mm
J1: Mega Harness; PinHeader_1x10_P2.54mm_Vertical
J2: Top ESC; PinHeader_1x03_P2.54mm_Vertical
J3: Btm ESC; PinHeader_1x03_P2.54mm_Vertical
J4: Agitator Servo; PinHeader_1x03_P2.54mm_Vertical
J5: Gate Servo; PinHeader_1x03_P2.54mm_Vertical
J6: Pan Servo; PinHeader_1x03_P2.54mm_Vertical
J7: Tilt Servo; PinHeader_1x03_P2.54mm_Vertical
J8: HM-10 BLE; PinHeader_1x04_P2.54mm_Vertical
J9: ATX Power In; PinHeader_1x04_P2.54mm_Vertical
R1: 1k Divider; R_Axial_DIN0207_L6.3mm_D2.5mm_P10.16mm_Horizontal
R2: 2k Divider; R_Axial_DIN0207_L6.3mm_D2.5mm_P10.16mm_Horizontal

Connections:
+5V_ATX: C2.1, J4.2, J5.2, J6.2, J7.2, J9.4
+5V_LOGIC: C3.1, J1.2, J8.2
+12V_ATX: C1.1, J9.1
AGIT_SERVO_D4: J1.5, J4.3
BLE_RX1_D19: J1.10, J8.3
BLE_RX_3V3: J8.4, R1.2, R2.1
BLE_TX1_D18: J1.9, R1.1
ESC_BTM_D3: J1.4, J3.3
ESC_TOP_D2: J1.3, J2.3
GATE_SERVO_D5: J1.6, J5.3
GND: C1.2, C2.2, C3.2, J1.1, J2.1, J2.2, J3.1, J3.2, J4.1, J5.1, J6.1, J7.1, J8.1, J9.2, J9.3, R2.2
PAN_SERVO_D6: J1.7, J6.3
TILT_SERVO_D7: J1.8, J7.3
